smvumbaco/Tubender-FA24/production/ecad/components/footprints/README.md

This is where all component footprints should go
