smvumbaco/Tubender-FA24/production/ecad/components/cad/BX56.IGS

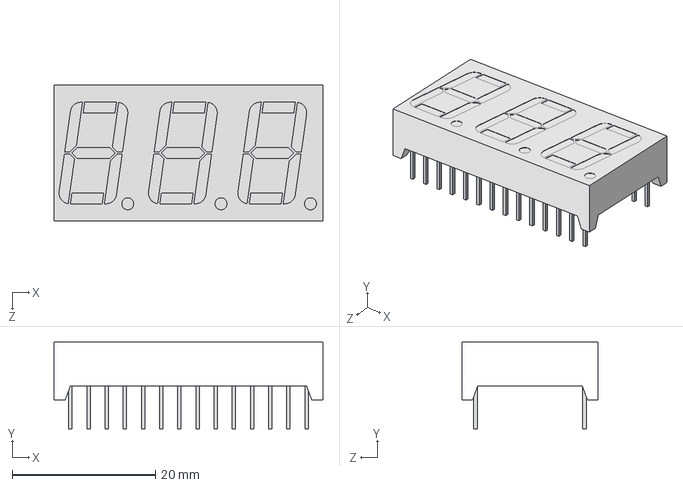
[picture p1: CAD file, 2024-11-20]
production/ecad/components/cad/BX56.IGS
37.6 x 12.1 x 19.0 mm
