smvumbaco/Tubender-FA24/production/ecad/components/cad/PEC11R-4215K-S0024.stp

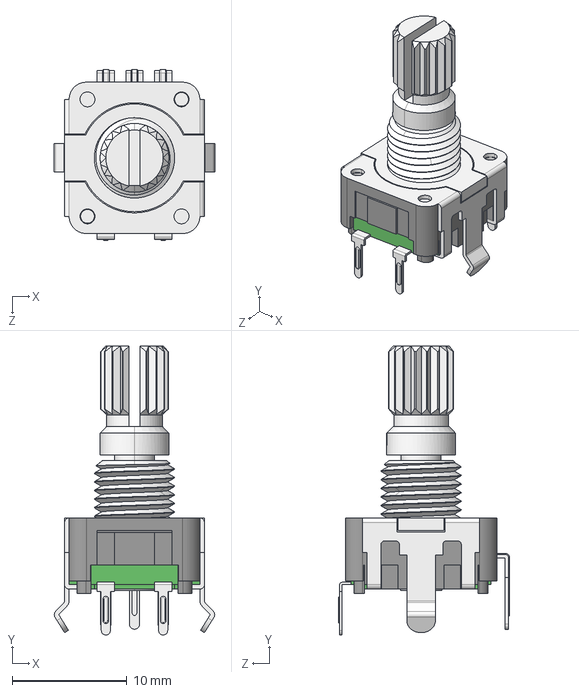
[picture p2: CAD file, 2024-11-20]
production/ecad/components/cad/PEC11R-4215K-S0024.stp
14.0 x 25.2 x 14.9 mm
