smvumbaco/Tubender-FA24/production/ecad/components/cad/D0016A.stp

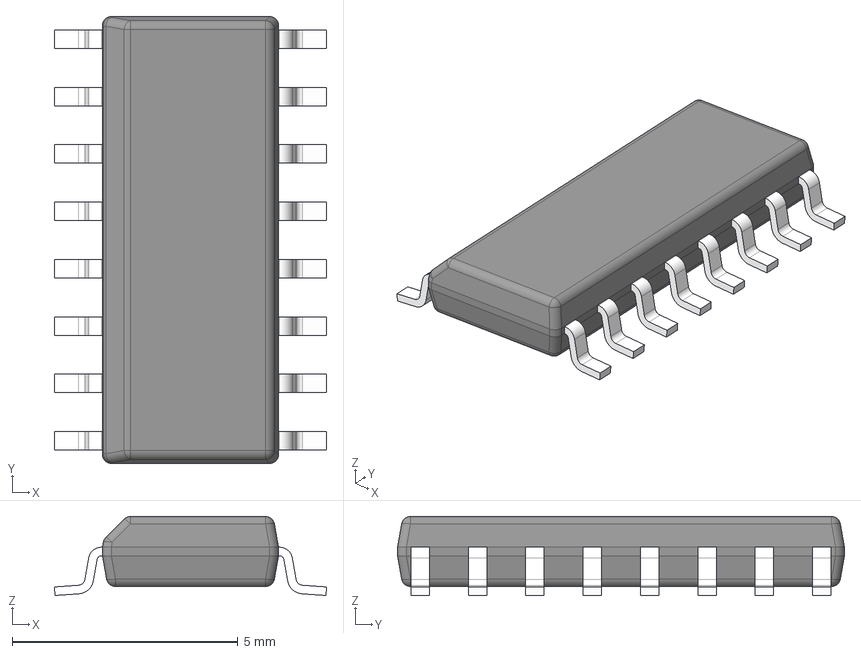
[picture p3: CAD file, 2024-11-20]
production/ecad/components/cad/D0016A.stp
6.03 x 9.90 x 1.75 mm
BODY-SO
LEAD-SO x 16
PIN1-ID
