smvumbaco/Tubender-FA24/production/ecad/components/cad/SN74LVC1G29DCTR.stp

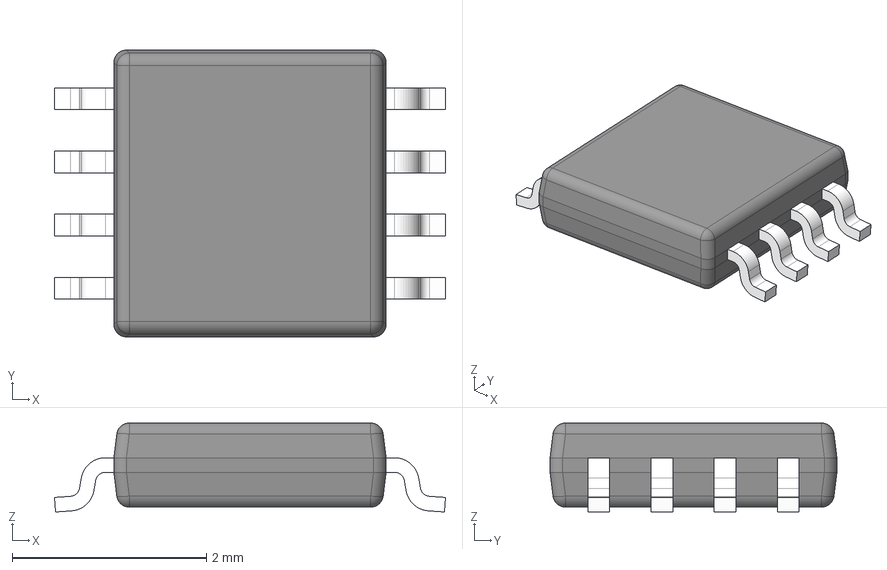
[picture p4: CAD file, 2024-11-20]
production/ecad/components/cad/SN74LVC1G29DCTR.stp
4.02 x 2.95 x 0.915 mm
BODY-SO
LEAD-SO x 8
PIN1-ID
