smvumbaco/Tubender-FA24/production/ecad/components/cad/CP2102N-A02-GQFN28.step

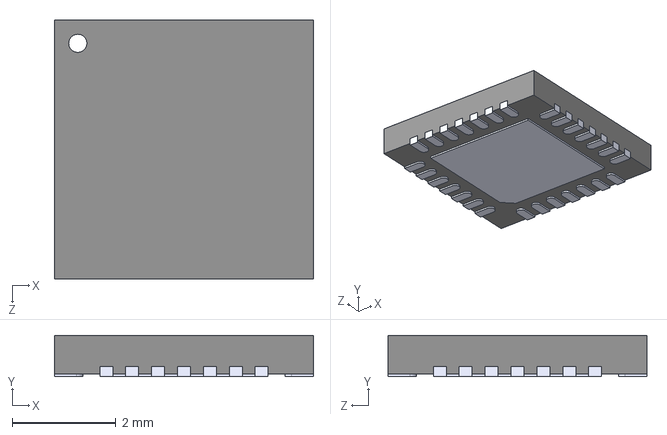
[picture p5: CAD file, 2024-10-16]
production/ecad/components/cad/CP2102N-A02-GQFN28.step
5.00 x 0.8 x 5.00 mm
