smvumbaco/Tubender-FA24/production/ecad/components/cad/1-640387-0.step

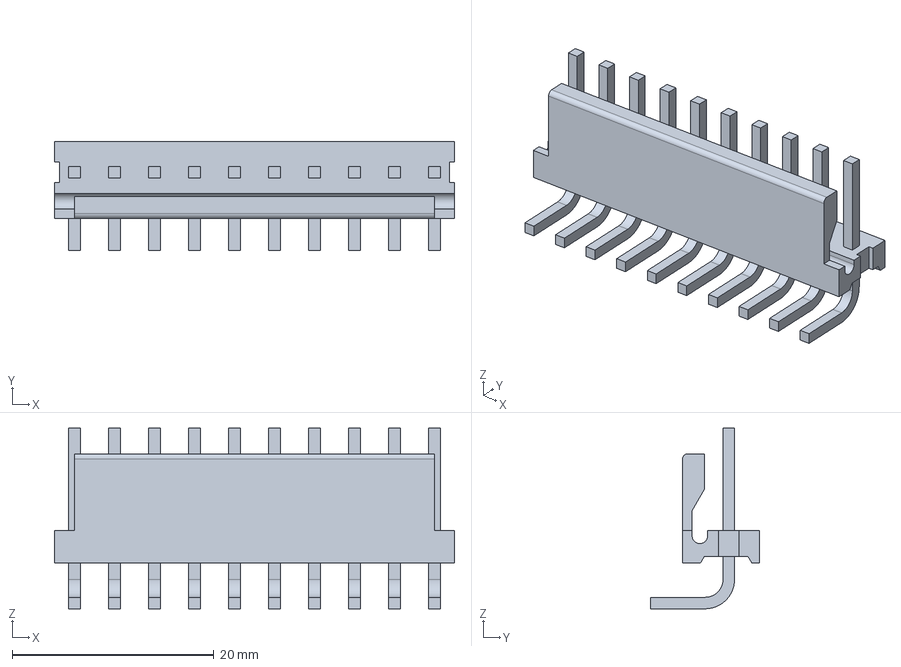
[picture p6: CAD file, 2024-10-16]
production/ecad/components/cad/1-640387-0.step
39.6 x 10.8 x 17.9 mm
