smvumbaco/Tubender-FA24/production/ecad/components/cad/5006.step

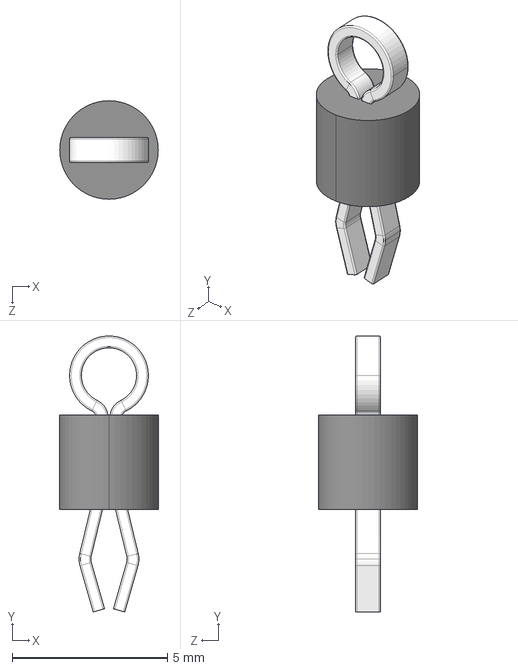
[picture p7: CAD file, 2024-10-16]
production/ecad/components/cad/5006.step
3.17 x 8.89 x 3.17 mm
