smvumbaco/Tubender-FA24/production/ecad/components/cad/ABM8-20.000MHz-10-B1U-T.step

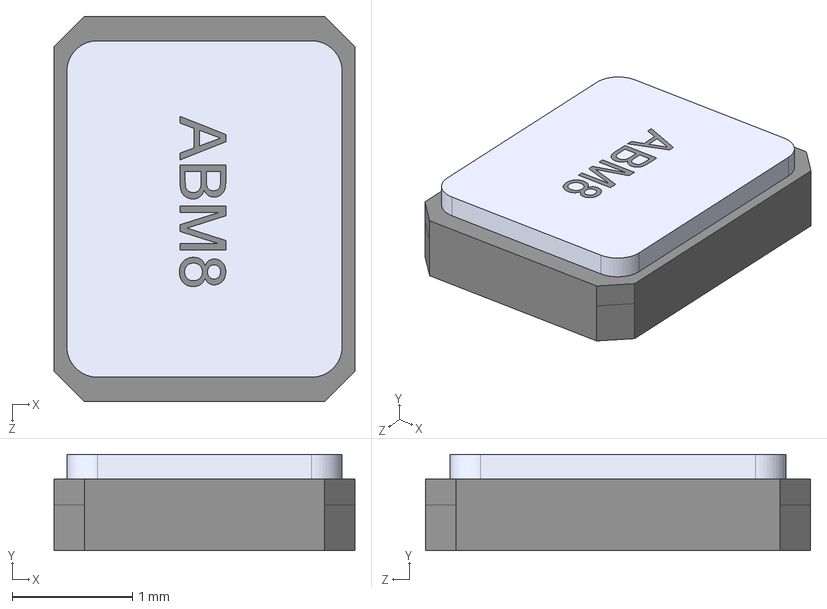
[picture p8: CAD file, 2024-10-11]
production/ecad/components/cad/ABM8-20.000MHz-10-B1U-T.step
2.50 x 0.8 x 3.20 mm
