smvumbaco/Tubender-FA24/production/ecad/components/cad/SN74AHC1G125DBVR.step

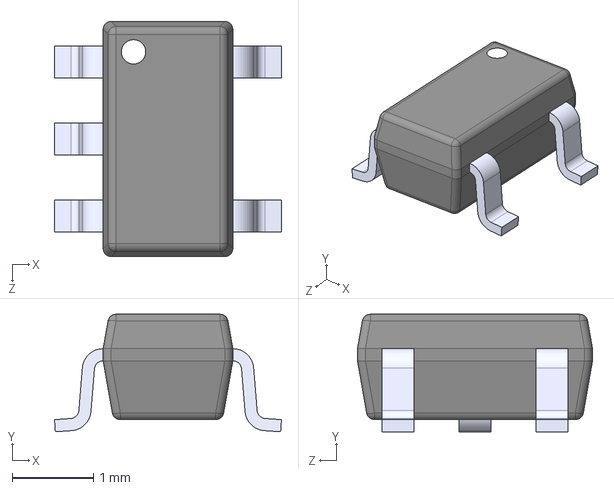
[picture p9: CAD file, 2024-10-11]
production/ecad/components/cad/SN74AHC1G125DBVR.step
2.80 x 1.45 x 2.90 mm
