smvumbaco/Tubender-FA24/production/ecad/components/cad/CD4051BE.step

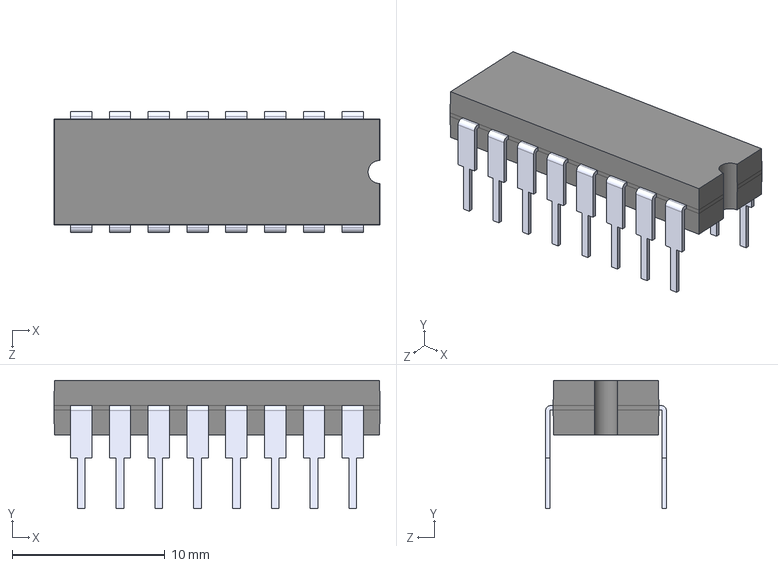
[picture p10: CAD file, 2024-10-11]
production/ecad/components/cad/CD4051BE.step
21.3 x 8.38 x 7.90 mm
