smvumbaco/Tubender-FA24/production/ecad/components/cad/TPSM265R1V5SILR.step

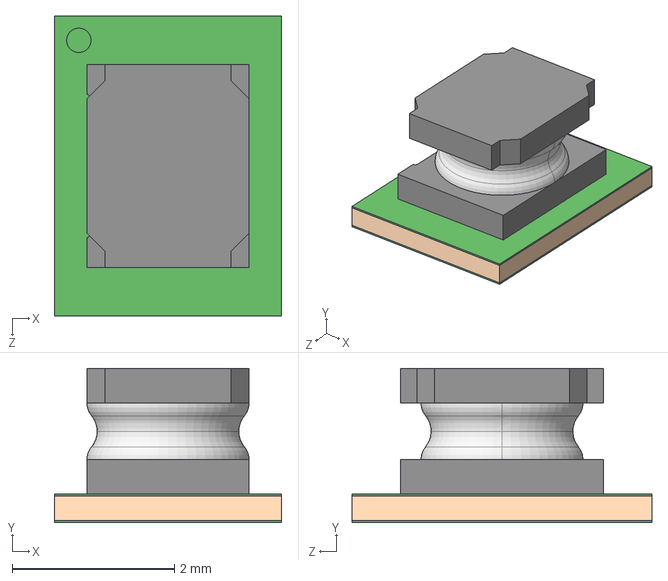
[picture p11: CAD file, 2024-10-10]
production/ecad/components/cad/TPSM265R1V5SILR.step
2.80 x 1.90 x 3.70 mm
