smvumbaco/Tubender-FA24/production/ecad/components/cad/AO3400A.step

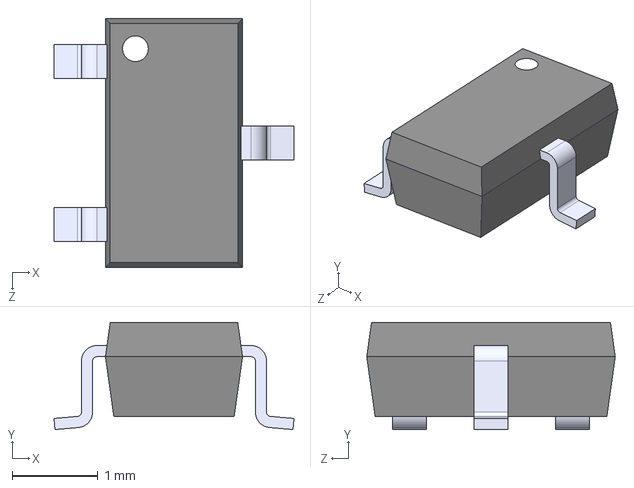
[picture p12: CAD file, 2024-10-03]
production/ecad/components/cad/AO3400A.step
2.80 x 1.25 x 2.90 mm
