smvumbaco/Tubender-FA24/production/ecad/components/cad/TS02-66-70-BK-260-LCR-D.step

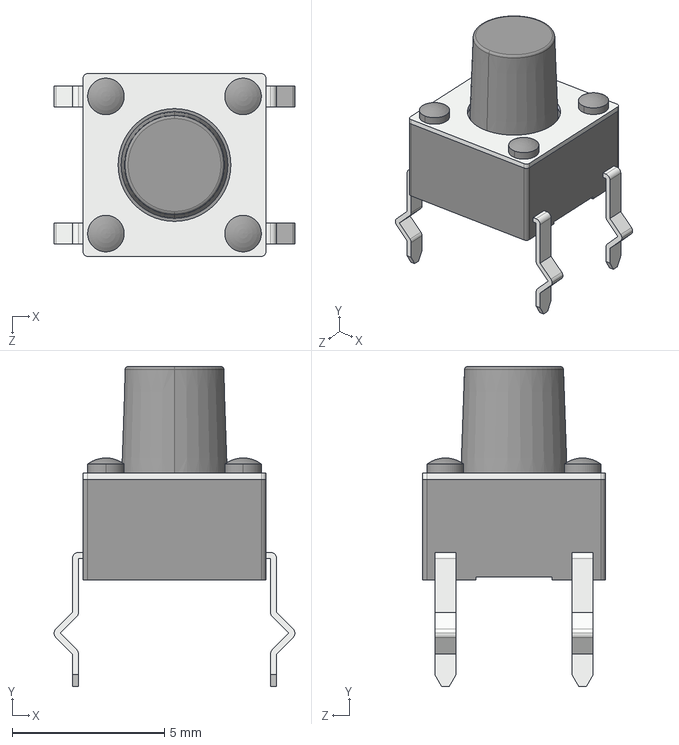
[picture p13: CAD file, 2024-10-03]
production/ecad/components/cad/TS02-66-70-BK-260-LCR-D.step
7.90 x 10.5 x 6.00 mm
