smvumbaco/Tubender-FA24/production/ecad/components/cad/1N5819HW-7-F.step

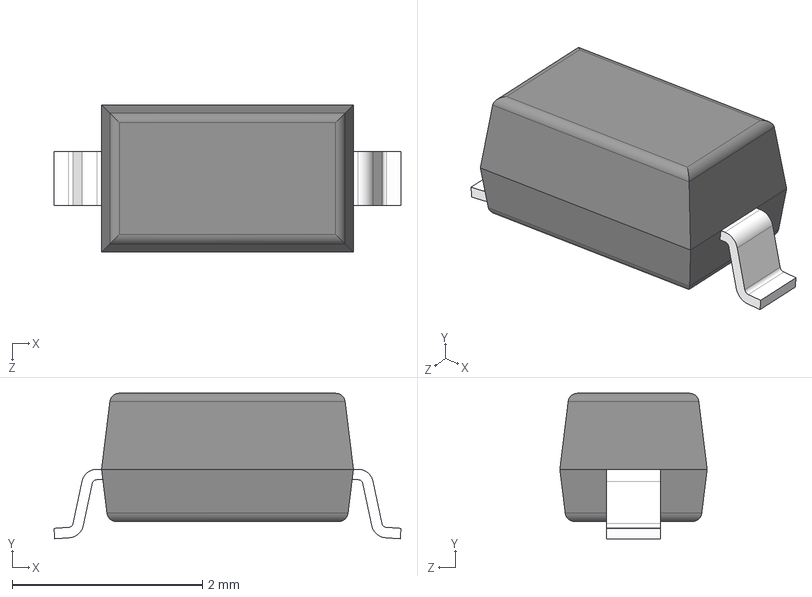
[picture p14: CAD file, 2024-10-03]
production/ecad/components/cad/1N5819HW-7-F.step
3.65 x 1.53 x 1.55 mm
