smvumbaco/Tubender-FA24/production/ecad/components/cad/WL-SMCW_0603.step

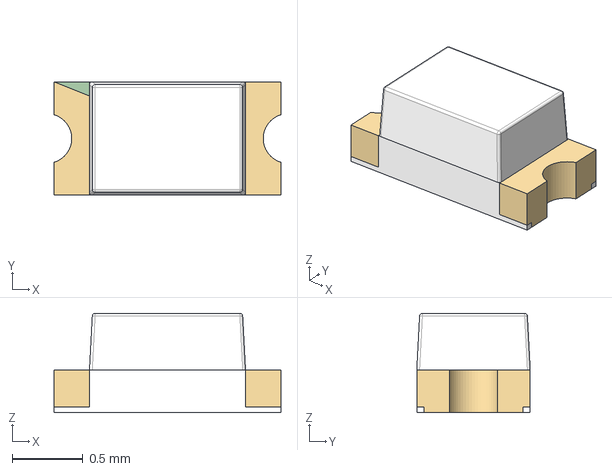
[picture p15: CAD file, 2024-10-03]
production/ecad/components/cad/WL-SMCW_0603.step
1.60 x 0.8 x 0.7 mm
