smvumbaco/Tubender-FA24/production/ecad/components/cad/FT232RL-REEL.step

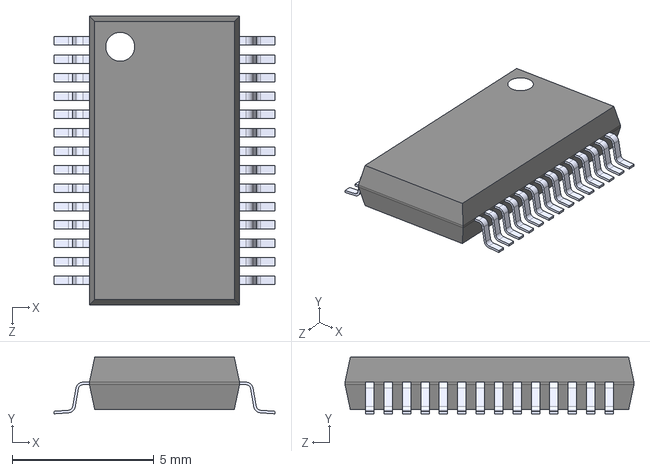
[picture p16: CAD file, 2024-10-03]
production/ecad/components/cad/FT232RL-REEL.step
7.80 x 2.00 x 10.2 mm
