smvumbaco/Tubender-FA24/production/ecad/components/cad/USB4110GFA.step

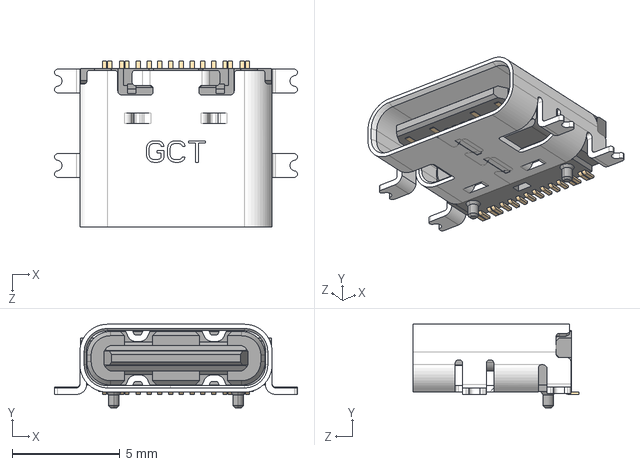
[picture p17: CAD file, 2024-10-03]
production/ecad/components/cad/USB4110GFA.step
11.3 x 3.89 x 7.70 mm
