smvumbaco/Tubender-FA24/production/ecad/components/cad/ESP32-WROOM-32UE_M113EH6400UH3Q0_.step

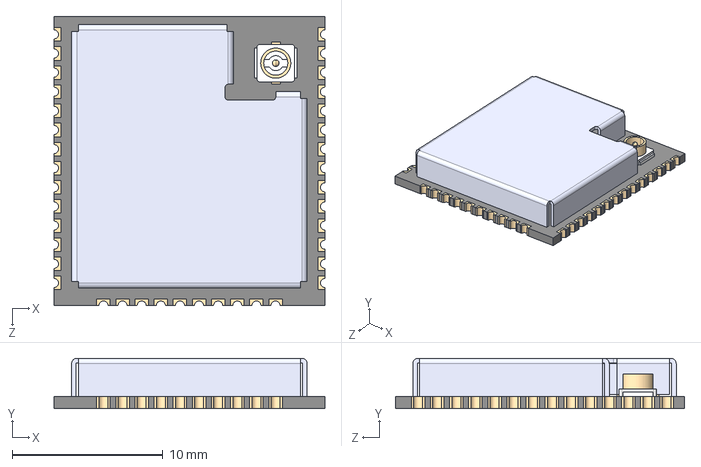
[picture p18: CAD file, 2024-10-03]
production/ecad/components/cad/ESP32-WROOM-32UE_M113EH6400UH3Q0_.step
18.0 x 3.35 x 19.2 mm
