smvumbaco/Tubender-FA24/(list of files, cad)

Other CAD files:
production/ecad/components/cad/104031-0811.stp
production/ecad/components/cad/1729157.step
production/ecad/components/cad/640387-3.step
production/ecad/components/cad/640387-5.stp
production/ecad/components/cad/640387-6.step
production/ecad/components/cad/640387-8.step
production/ecad/components/cad/JS202011JCQN.step
production/ecad/components/cad/LMR36520FADDAR.step
production/ecad/components/cad/MCP23017-E_SO.step
