smvumbaco/Tubender-FA24/production/ecad/Tubender UI_PCB/Tubender UI_PCB.kicad_pcb

## KiCad design production/ecad/Tubender UI_PCB/Tubender UI_PCB.kicad_pcb (2024-11-20)

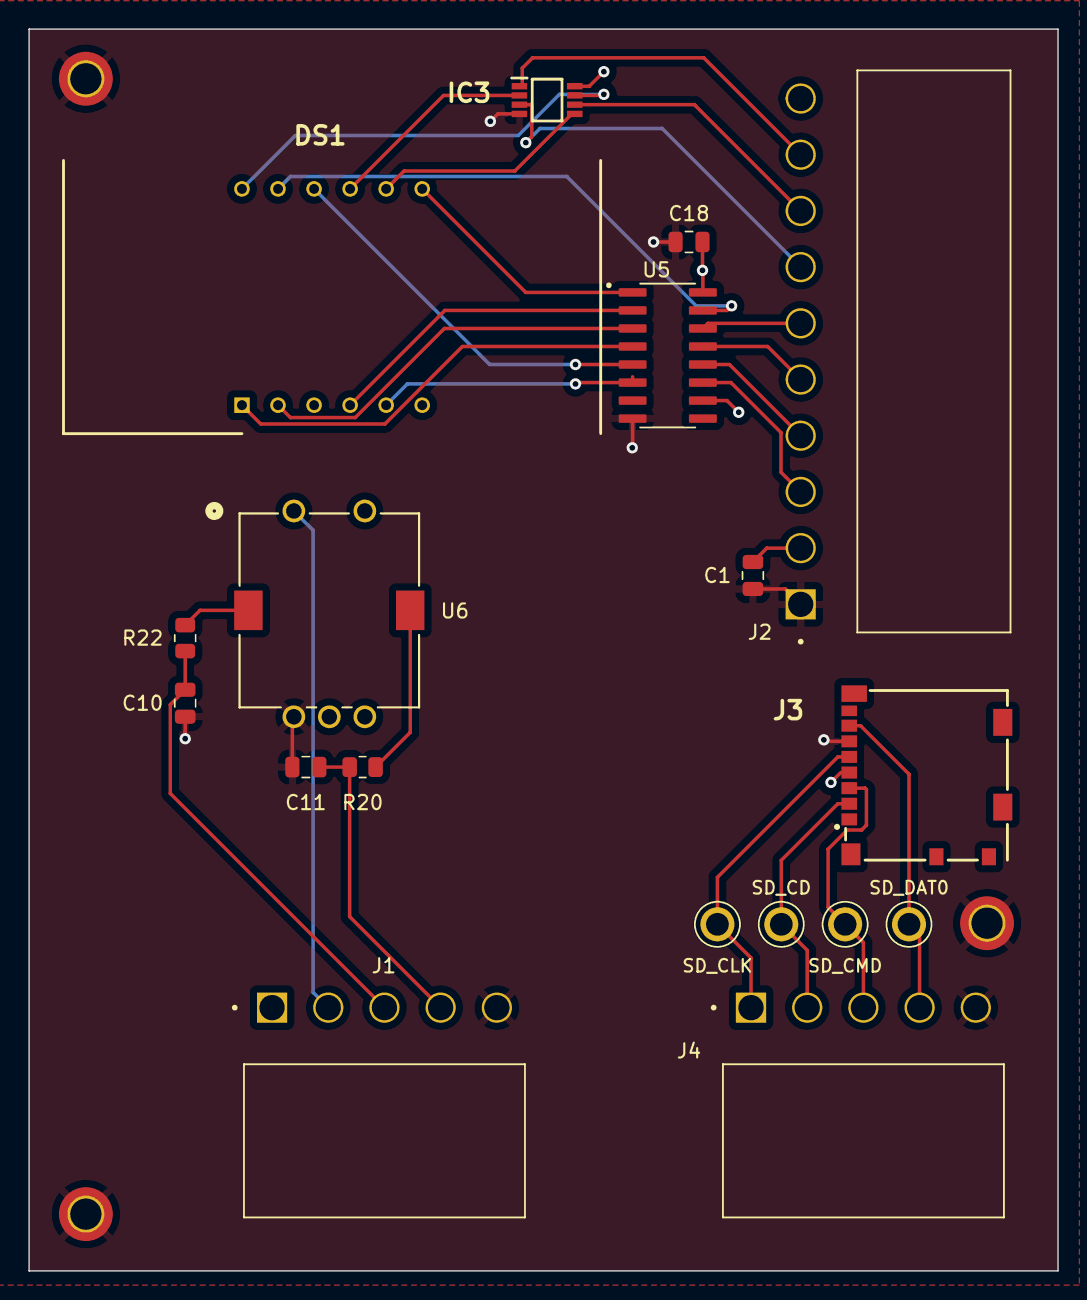
[picture p19: board Tubender UI_PCB.kicad_pcb from above]

Board: 4 copper layers, 72.5 x 87.5 mm, 18 parts (0 on the bottom side), 29 nets.

Parts:
C1: 0.1u; C_0805_2012Metric
C10, C11: 0.01u; C_0805_2012Metric
C18: 0.1uF; C_0805_2012Metric
DS1: BC56-12EWA; DIPS1524W50P254L3760H835Q12N
IC3: SN74LVC1G29DCTR; SOP65P400X130-8N
J1, J4: 640387-5; TE_640387-5
J2: 1-640387-0; TE_1-640387-0
J3: 104031-0811; 1040310811
R20, R22: 10k; R_0805_2012Metric
SD_CD: 5006; KEYSTONE_5006
SD_CLK: 5006; KEYSTONE_5006
SD_CMD: 5006; KEYSTONE_5006
SD_DAT0: 5006; KEYSTONE_5006
U5: 74HC595; SOIC127P600X175-16N
U6: PEC11R-4215K-S0024; SW_PEC11R-4XXXK-SXXXX_BRN

Connections:
7-SEG_A0: IC3.3 (A0), J2.7
7-SEG_A1: IC3.6 (A1), J2.8
7-SEG_Gb: IC3.1 (~G), J2.9
7-SEG_OEb: J2.5, U5.13 (~OE)
7-SEG_RCLK: J2.4, U5.12 (RCLK)
7-SEG_SER: J2.6, U5.14 (SER)
7-SEG_SRCLK: J2.3, U5.11 (SRCLK)
+3V3: C1.1, J2.2, J3.4 (VDD), U5.10 (~SRCLR)
+5V: C18.1, IC3.8 (VCC), J1.1, J2.10, U5.16 (VCC), U6.2
DIAL_BUTTON: J1.2, U6.1
DIAL_CHANNEL_A: C10.1, J1.3, R22.2
DIAL_CHANNEL_B: C11.1, J1.4, R20.2
GND: C1.2, C10.2, C11.2, C18.2, IC3.4 (GND), J1.5, J2.1, J3.6 (VSS), J4.5, U5.8 (GND), U6.5 (C)
unnamed: DS1.11 (ANODE_A), U5.15 (QA)
unnamed: DS1.7 (ANODE_B), U5.1 (QB)
unnamed: DS1.4 (ANODE_C), U5.2 (QC)
unnamed: DS1.2 (ANODE_D), U5.3 (QD)
unnamed: DS1.1 (ANODE_E), U5.4 (QE)
unnamed: DS1.10 (ANODE_F), U5.5 (QF)
unnamed: DS1.5 (ANODE_G), U5.6 (QG)
unnamed: DS1.12 (COMMON_CATHODE_DIG1), IC3.7 (Y0)
unnamed: DS1.9 (COMMON_CATHODE_DIG2), IC3.2 (Y1)
unnamed: DS1.8 (COMMON_CATHODE_DIG_3), IC3.5 (Y2)
unnamed: R22.1, U6.3 (A)
unnamed: R20.1, U6.4 (B)
SD_CD: J3.2 (CD/DAT3), J4.2, SD_CD.TP
SD_CLK: J3.5 (CLK), J4.1, SD_CLK.TP
SD_CMD: J3.3 (CMD), J4.3, SD_CMD.TP
SD_DAT0: J3.7 (DAT0), J4.4, SD_DAT0.TP
