smvumbaco/Tubender-FA24/production/ecad/Tubender PCB/Tubender PCB.kicad_pcb

## KiCad design production/ecad/Tubender PCB/Tubender PCB.kicad_pcb (2024-11-03)

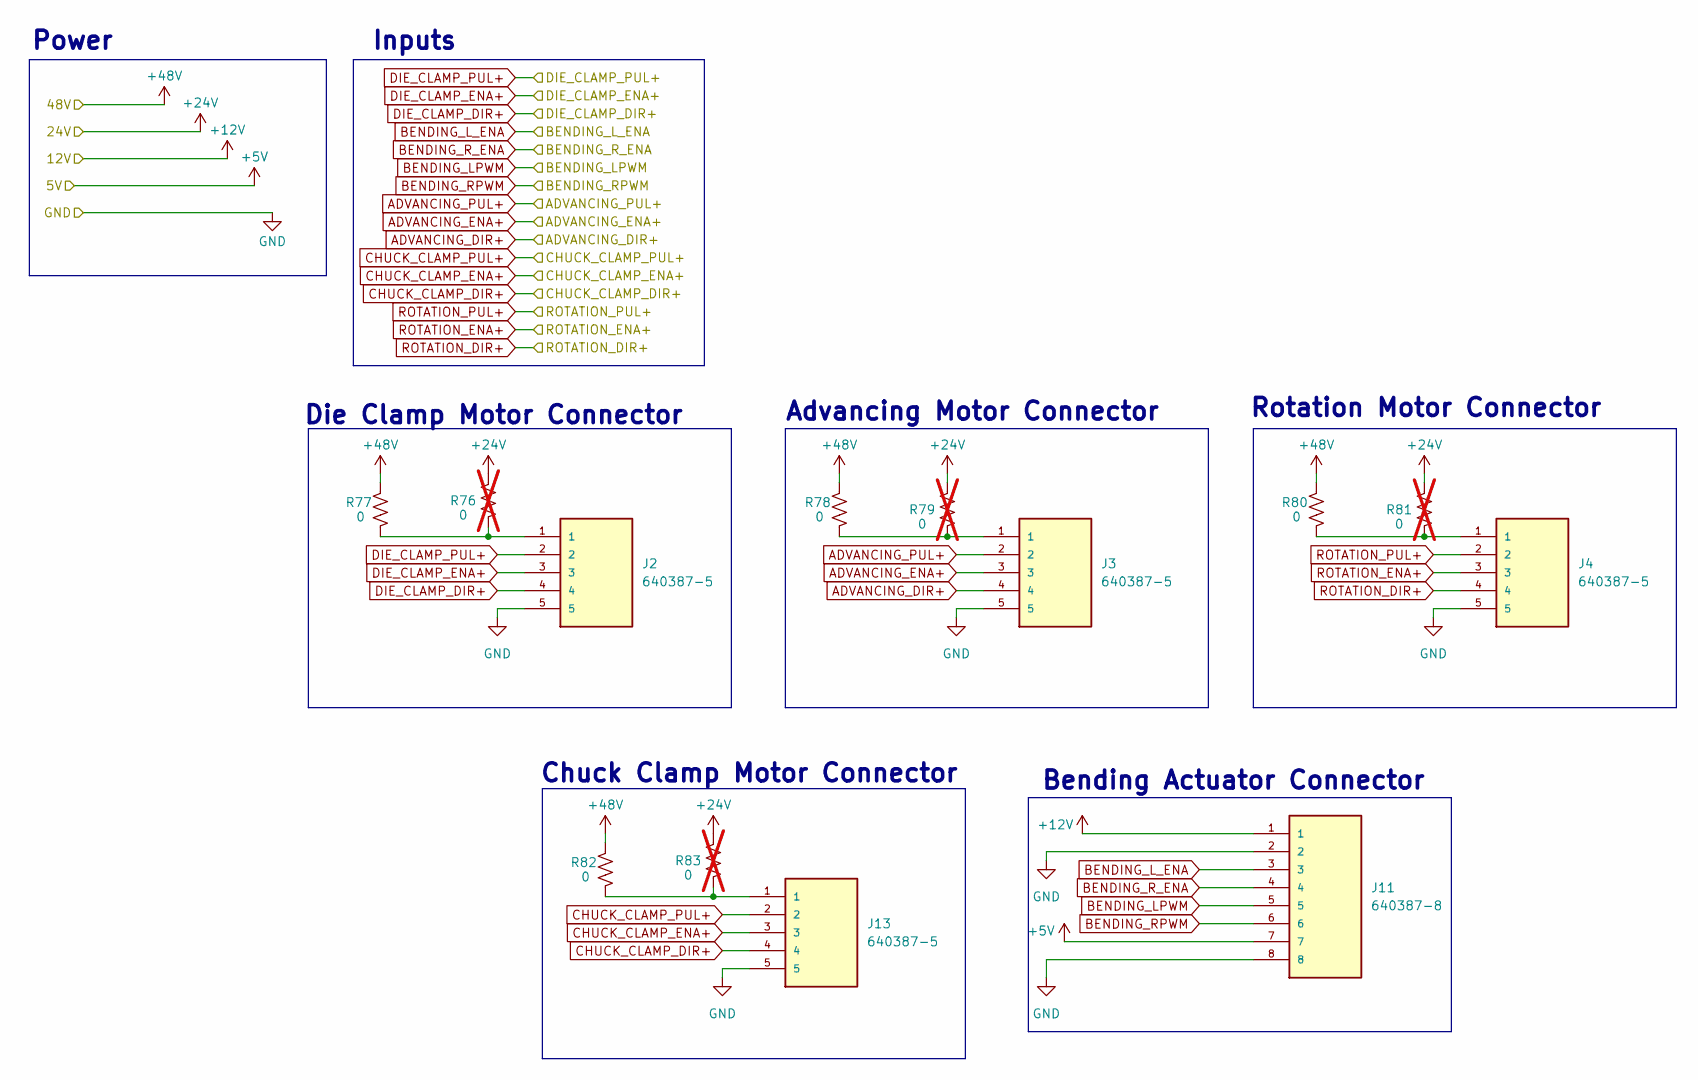
[picture p20: schematic motors_actuators.kicad_sch]

Parts:
J2, J3, J4, J13: 640387-5; TE_640387-5; PARTREV R
J11: 640387-8; TE_640387-8; PARTREV R
R76, R79, R81, R83: 0; R_0805_2012Metric; not fitted
R77, R78, R80, R82: 0; R_0805_2012Metric

Connections:
24V: R76.2, R79.2, R81.2, R83.2; also elsewhere on the board
48V: R77.2, R78.2, R80.2, R82.2; also elsewhere on the board
ADVANCING_DIR+: J3.4; also elsewhere on the board
ADVANCING_ENA+: J3.3; also elsewhere on the board
ADVANCING_PUL+: J3.2; also elsewhere on the board
BENDING_LPWM: J11.5; also elsewhere on the board
BENDING_L_ENA: J11.3; also elsewhere on the board
BENDING_RPWM: J11.6; also elsewhere on the board
BENDING_R_ENA: J11.4; also elsewhere on the board
CHUCK_CLAMP_DIR+: J13.4; also elsewhere on the board
CHUCK_CLAMP_ENA+: J13.3; also elsewhere on the board
CHUCK_CLAMP_PUL+: J13.2; also elsewhere on the board
DIE_CLAMP_DIR+: J2.4; also elsewhere on the board
DIE_CLAMP_ENA+: J2.3; also elsewhere on the board
DIE_CLAMP_PUL+: J2.2; also elsewhere on the board
unnamed: J2.1, R76.1, R77.1
unnamed: J3.1, R78.1, R79.1
unnamed: J4.1, R80.1, R81.1
unnamed: J13.1, R82.1, R83.1
ROTATION_DIR+: J4.4; also elsewhere on the board
ROTATION_ENA+: J4.3; also elsewhere on the board
ROTATION_PUL+: J4.2; also elsewhere on the board

Notes on the sheet:
Chuck Clamp Motor Connector
Die Clamp Motor Connector
Bending Actuator Connector
Inputs
Advancing Motor Connector
Power
Rotation Motor Connector

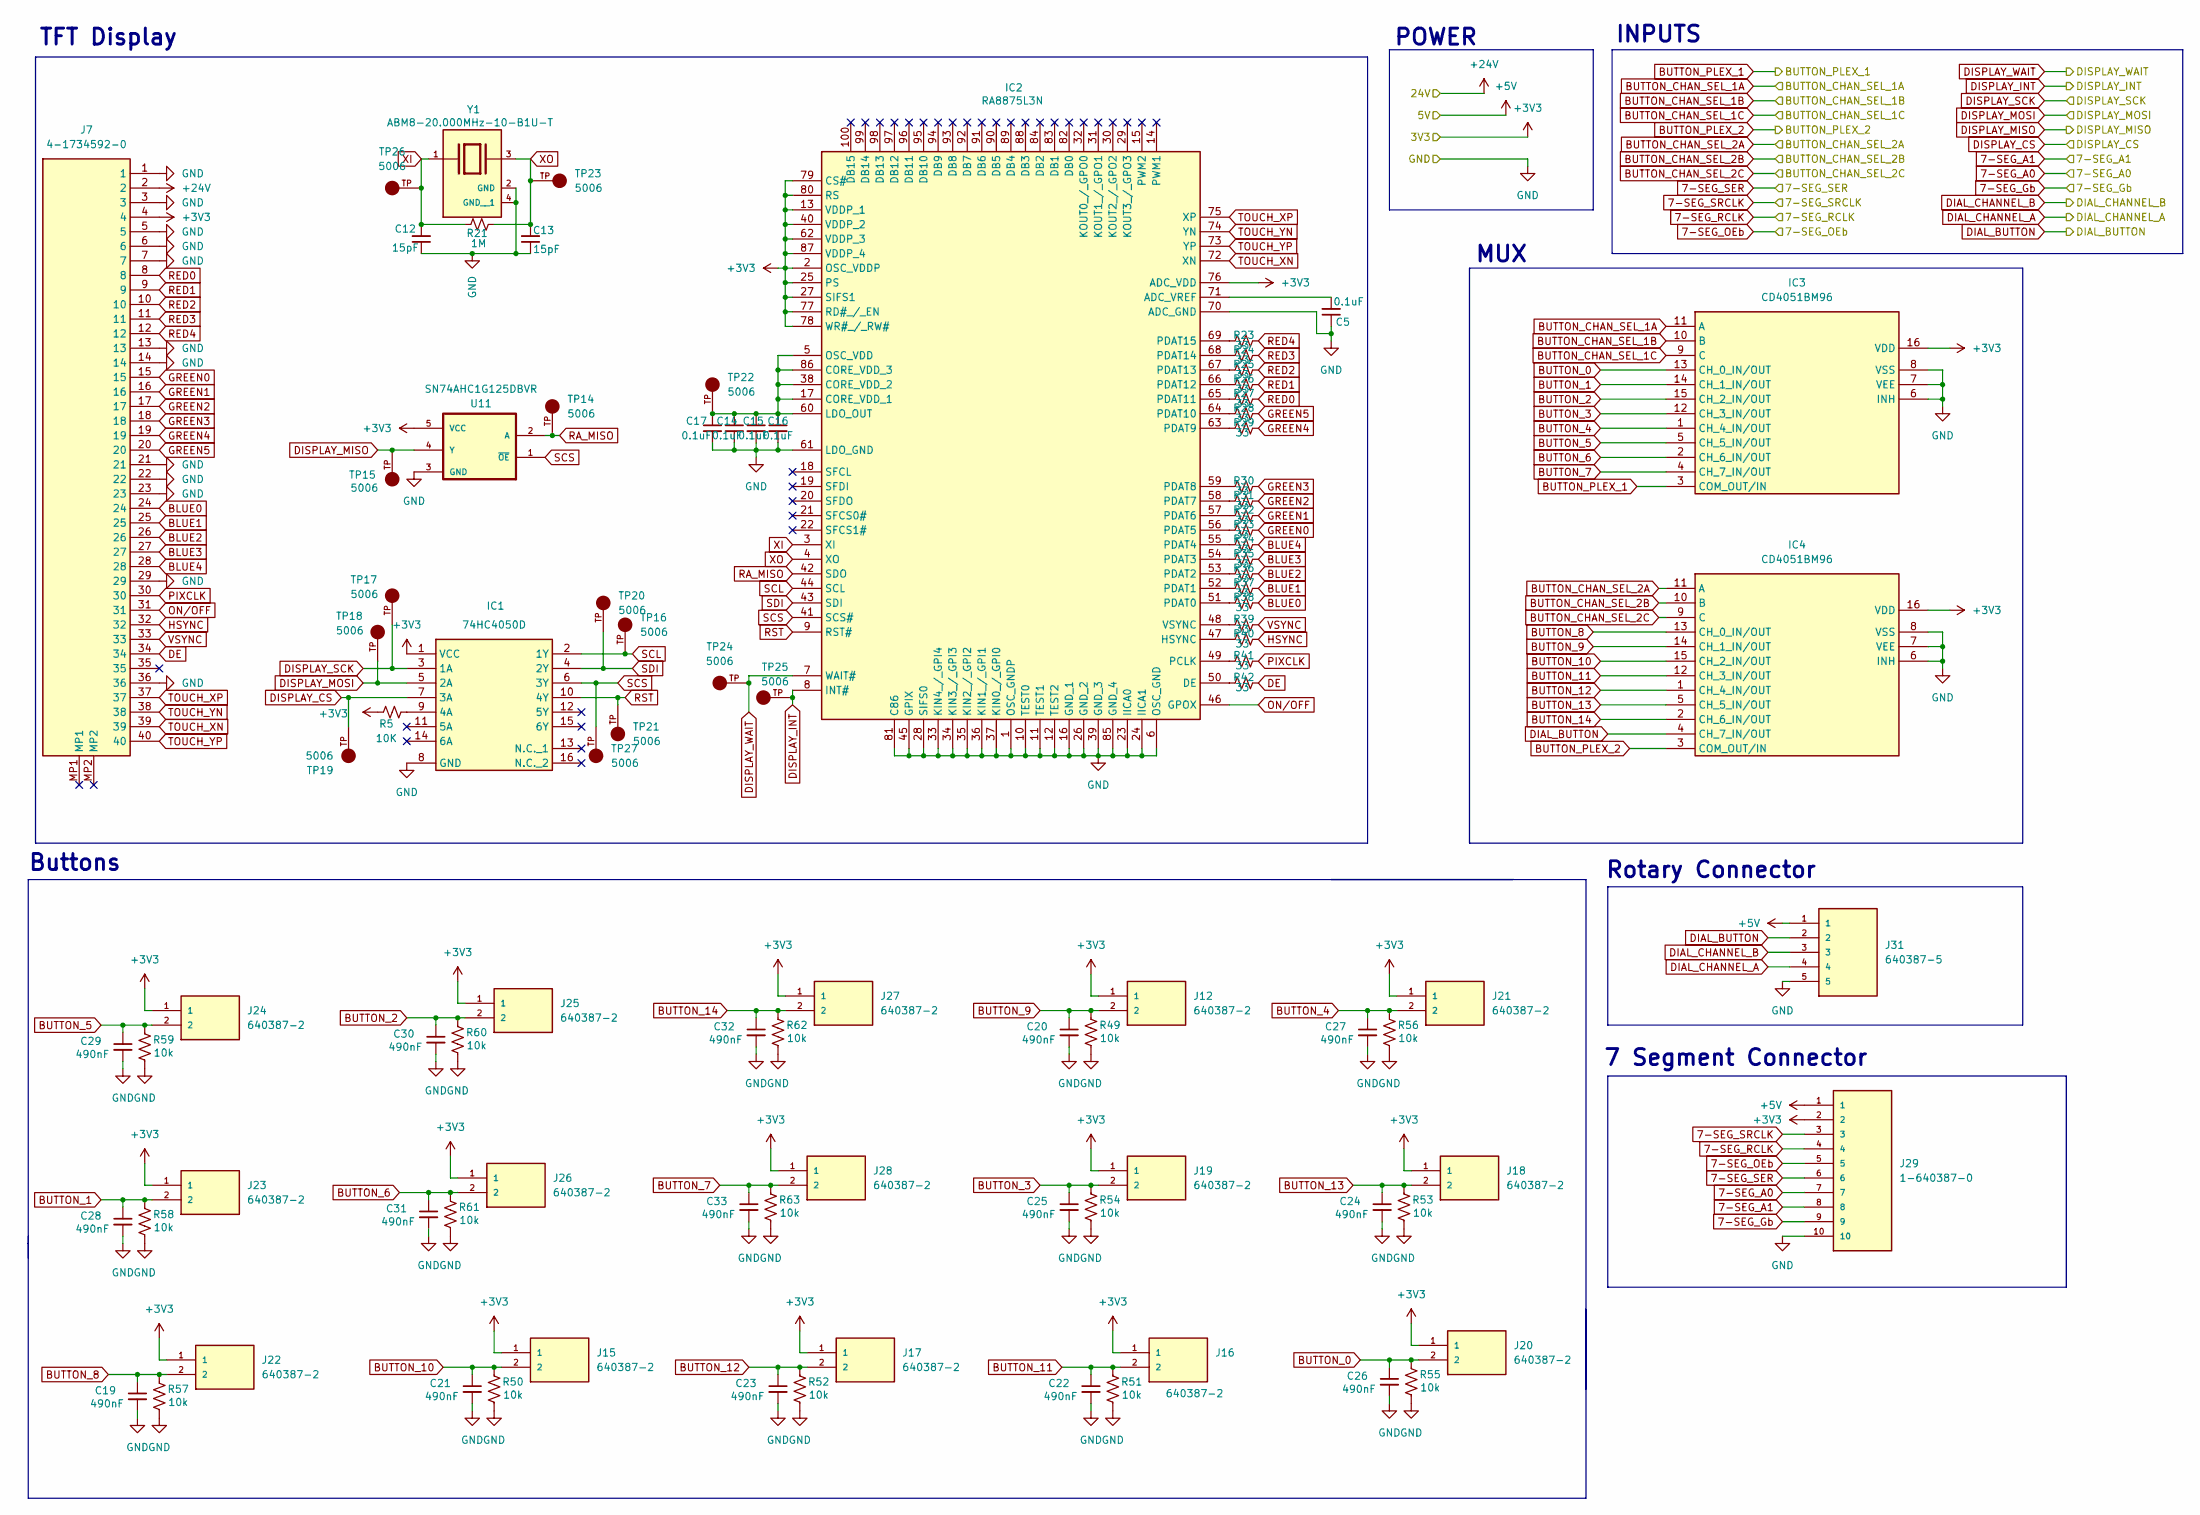
[picture p21: schematic user_interface.kicad_sch]

Parts:
C5, C14, C15, C16, C17: 0.1uF; C_0805_2012Metric
C12, C13: 15pF; C_0805_2012Metric
C19, C20, C21, C22, C23, C24, C25, C26, C27, C28, C29, C30, C31, C32, C33: 490nF; C_0805_2012Metric
IC1: 74HC4050D; SOT109-1_NXP; Manufacturer_Part_Number 74HC4050D; Mouser Part Number 771-74HC4050D
IC2: RA8875L3N; QFP40P1600X1600X160-128N; Manufacturer_Part_Number RA8875L3N
IC3, IC4: CD4051BM96; SOIC127P600X175-16N; Manufacturer_Part_Number CD4051BM96; Mouser Part Number 595-CD4051BM96
J7: 4-1734592-0; TE_4-1734592-0; Manufacturer_Part_Number 4-1734592-0; Mouser Part Number 571-4-1734592-0
J12, J15, J16, J17, J18, J19, J20, J21, J22, J23, J24, J25, J26, J27, J28: 640387-2; TE_640387-2; PARTREV R
J29: 1-640387-0; TE_1-640387-0; PARTREV R
J31: 640387-5; TE_640387-5; PARTREV R
R5: 10K; R_0805_2012Metric
R21: 1M; R_0805_2012Metric
R23, R24, R25, R26, R27, R28, R29, R30, R31, R32, R33, R34, R35, R36, R37, R38, R39, R40, R41, R42: 33; R_0805_2012Metric
R49, R50, R51, R52, R53, R54, R55, R56, R57, R58, R59, R60, R61, R62, R63: 10k; R_0805_2012Metric
TP14, TP15, TP16, TP17, TP18, TP19, TP20, TP21, TP22, TP23, TP24, TP25, TP26, TP27: 5006; KEYSTONE_5006; PARTREV F
U11: SN74AHC1G125DBVR; SOT95P280X145-5N
Y1: ABM8-20.000MHz-10-B1U-T; XTAL_ABM8-20.000MHz-10-B1U-T; PARTREV 44041

Connections:
3.3V: IC1.1 (VCC), IC2.2 (OSC_VDDP), IC2.13 (VDDP_1), IC2.25 (PS), IC2.27 (SIFS1), IC2.40 (VDDP_2), IC2.62 (VDDP_3), IC2.76 (ADC_VDD), IC2.77 (RD#_/_EN), IC2.78 (WR#_/_RW#), IC2.79 (CS#), IC2.80 (RS), IC2.87 (VDDP_4), IC3.16 (VDD), IC4.16 (VDD), J7.4, J12.1, J15.1, J16.1, J17.1, J18.1, J19.1, J20.1, J21.1, J22.1, J23.1, J24.1, J25.1, J26.1, J27.1, J28.1, J29.2, R5.2, U11.5 (VCC); also elsewhere on the board
7-SEG_A0: J29.7; also elsewhere on the board
7-SEG_A1: J29.8; also elsewhere on the board
7-SEG_Gb: J29.9; also elsewhere on the board
7-SEG_OEb: J29.5; also elsewhere on the board
7-SEG_RCLK: J29.4; also elsewhere on the board
7-SEG_SER: J29.6; also elsewhere on the board
7-SEG_SRCLK: J29.3; also elsewhere on the board
24V: J7.2; also elsewhere on the board
BLUE0: J7.24, R38.2
BLUE1: J7.25, R37.2
BLUE2: J7.26, R36.2
BLUE3: J7.27, R35.2
BLUE4: J7.28, R34.2
BUTTON_0: C26.1, IC3.13 (CH_0_IN/OUT), J20.2, R55.2
BUTTON_1: C28.1, IC3.14 (CH_1_IN/OUT), J23.2, R58.2
BUTTON_2: C30.1, IC3.15 (CH_2_IN/OUT), J25.2, R60.2
BUTTON_3: C25.1, IC3.12 (CH_3_IN/OUT), J19.2, R54.2
BUTTON_4: C27.1, IC3.1 (CH_4_IN/OUT), J21.2, R56.2
BUTTON_5: C29.1, IC3.5 (CH_5_IN/OUT), J24.2, R59.2
BUTTON_6: C31.1, IC3.2 (CH_6_IN/OUT), J26.2, R61.2
BUTTON_7: C33.1, IC3.4 (CH_7_IN/OUT), J28.2, R63.2
BUTTON_8: C19.1, IC4.13 (CH_0_IN/OUT), J22.2, R57.2
BUTTON_9: C20.1, IC4.14 (CH_1_IN/OUT), J12.2, R49.2
BUTTON_10: C21.1, IC4.15 (CH_2_IN/OUT), J15.2, R50.2
BUTTON_11: C22.1, IC4.12 (CH_3_IN/OUT), J16.2, R51.2
BUTTON_12: C23.1, IC4.1 (CH_4_IN/OUT), J17.2, R52.2
BUTTON_13: C24.1, IC4.5 (CH_5_IN/OUT), J18.2, R53.2
BUTTON_14: C32.1, IC4.2 (CH_6_IN/OUT), J27.2, R62.2
BUTTON_CHAN_SEL_1A: IC3.11 (A); also elsewhere on the board
BUTTON_CHAN_SEL_1B: IC3.10 (B); also elsewhere on the board
BUTTON_CHAN_SEL_1C: IC3.9 (C); also elsewhere on the board
BUTTON_CHAN_SEL_2A: IC4.11 (A); also elsewhere on the board
BUTTON_CHAN_SEL_2B: IC4.10 (B); also elsewhere on the board
BUTTON_CHAN_SEL_2C: IC4.9 (C); also elsewhere on the board
BUTTON_PLEX_1: IC3.3 (COM_OUT/IN); also elsewhere on the board
BUTTON_PLEX_2: IC4.3 (COM_OUT/IN); also elsewhere on the board
DE: J7.34, R42.2
DIAL_BUTTON: IC4.4 (CH_7_IN/OUT), J31.2
DIAL_CHANNEL_A: J31.4; also elsewhere on the board
DIAL_CHANNEL_B: J31.3; also elsewhere on the board
DISPLAY_CS: IC1.7 (3A), TP19.TP; also elsewhere on the board
DISPLAY_INT: IC2.8 (INT#), TP25.TP; also elsewhere on the board
DISPLAY_MISO: TP15.TP, U11.4 (Y); also elsewhere on the board
DISPLAY_MOSI: IC1.5 (2A), TP18.TP; also elsewhere on the board
DISPLAY_SCK: IC1.3 (1A), TP17.TP; also elsewhere on the board
DISPLAY_WAIT: IC2.7 (WAIT#), TP24.TP; also elsewhere on the board
GREEN0: J7.15, R33.2
GREEN1: J7.16, R32.2
GREEN2: J7.17, R31.2
GREEN3: J7.18, R30.2
GREEN4: J7.19, R29.2
GREEN5: J7.20, R28.2
HSYNC: J7.32, R40.2
unnamed: IC1.9 (4A), R5.1
unnamed: C5.2, IC2.71 (ADC_VREF)
unnamed: C14.1, C15.1, C16.1, C17.1, IC2.5 (OSC_VDD), IC2.17 (CORE_VDD_1), IC2.38 (CORE_VDD_2), IC2.60 (LDO_OUT), IC2.86 (CORE_VDD_3), TP22.TP
unnamed: IC2.50 (DE), R42.1
unnamed: IC2.47 (HSYNC), R40.1
unnamed: IC2.49 (PCLK), R41.1
unnamed: IC2.51 (PDAT0), R38.1
unnamed: IC2.52 (PDAT1), R37.1
unnamed: IC2.53 (PDAT2), R36.1
unnamed: IC2.54 (PDAT3), R35.1
unnamed: IC2.55 (PDAT4), R34.1
unnamed: IC2.56 (PDAT5), R33.1
unnamed: IC2.57 (PDAT6), R32.1
unnamed: IC2.58 (PDAT7), R31.1
unnamed: IC2.59 (PDAT8), R30.1
unnamed: IC2.63 (PDAT9), R29.1
unnamed: IC2.64 (PDAT10), R28.1
unnamed: IC2.65 (PDAT11), R27.1
unnamed: IC2.66 (PDAT12), R26.1
unnamed: IC2.67 (PDAT13), R25.1
unnamed: IC2.68 (PDAT14), R24.1
unnamed: IC2.69 (PDAT15), R23.1
unnamed: IC2.48 (VSYNC), R39.1
ON/OFF: IC2.46 (GPOX), J7.31
PIXCLK: J7.30, R41.2
RA_MISO: IC2.42 (SDO), TP14.TP, U11.2 (A)
RED0: J7.8, R27.2
RED1: J7.9, R26.2
RED2: J7.10, R25.2
RED3: J7.11, R24.2
RED4: J7.12, R23.2
RST: IC1.10 (4Y), IC2.9 (RST#), TP21.TP
SCL: IC1.2 (1Y), IC2.44 (SCL), TP16.TP
SCS: IC1.6 (3Y), IC2.41 (SCS#), TP27.TP, U11.1 (~OE)
SDI: IC1.4 (2Y), IC2.43 (SDI), TP20.TP
TOUCH_XN: IC2.72 (XN), J7.39
TOUCH_XP: IC2.75 (XP), J7.37
TOUCH_YN: IC2.74 (YN), J7.38
TOUCH_YP: IC2.73 (YP), J7.40
VSYNC: J7.33, R39.2
XI: C12.2, IC2.3 (XI), R21.1, TP26.TP, Y1.1
XO: C13.2, IC2.4 (XO), R21.2, TP23.TP, Y1.3

Notes on the sheet:
INPUTS
POWER
TFT Display
MUX
7 Segment Connector
Rotary Connector
Buttons

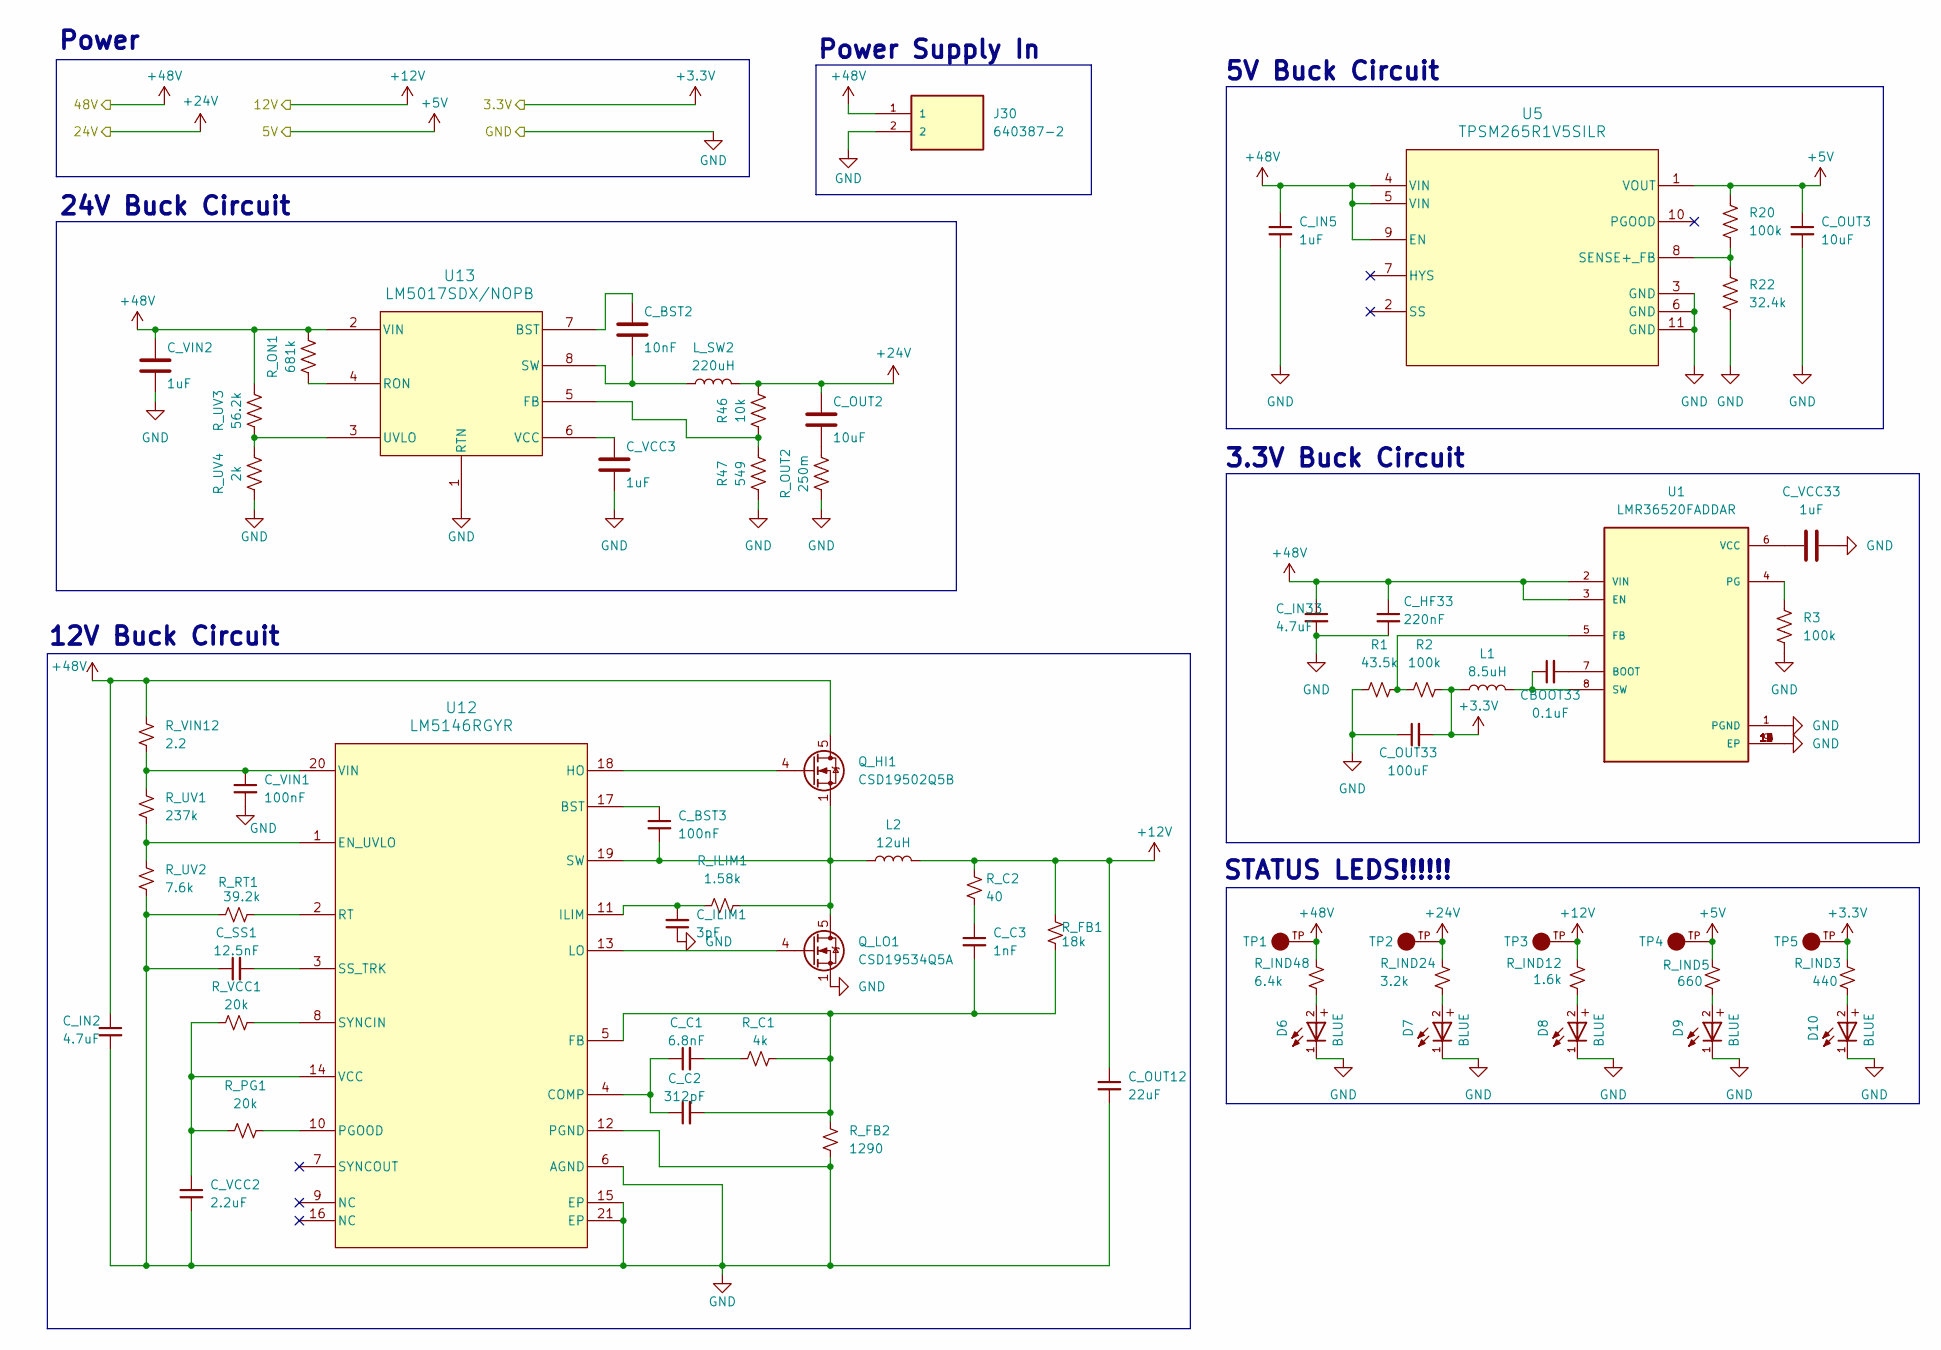
[picture p22: schematic power.kicad_sch]

Parts:
CBOOT33: 0.1uF; C_0805_2012Metric
C_BST2: 10nF; C_0805_2012Metric
C_BST3: 100nF; C_0805_2012Metric
C_C1: 6.8nF; C_0805_2012Metric
C_C2: 312pF; C_0805_2012Metric
C_C3: 1nF; C_0805_2012Metric
C_HF33: 220nF; C_0805_2012Metric
C_ILIM1: 3pF; C_0805_2012Metric
C_IN2, C_IN33: 4.7uF; C_0805_2012Metric
C_IN5: 1uF; C_0805_2012Metric
C_OUT2, C_OUT3: 10uF; C_0805_2012Metric
C_OUT12: 22uF; C_0805_2012Metric
C_OUT33: 100uF; C_0805_2012Metric
C_SS1: 12.5nF; C_0805_2012Metric
C_VCC2: 2.2uF; C_0805_2012Metric
C_VCC3, C_VCC33: 1uF; C_0805_2012Metric
C_VIN1: 100nF; C_0805_2012Metric
C_VIN2: 1uF; C_0805_2012Metric
D6, D7, D8, D9, D10: BLUE; WL-SMCW_0603
J30: 640387-2; TE_640387-2; PARTREV R
L1: 8.5uH; L_0805_2012Metric
L2: 12uH; L_0805_2012Metric
L_SW2: 220uH; L_0805_2012Metric
Q_HI1: CSD19502Q5B; TDSON-8-1
Q_LO1: CSD19534Q5A; TDSON-8-1
R1: 43.5k; R_0805_2012Metric
R2, R3, R20: 100k; R_0805_2012Metric
R22: 32.4k; R_0805_2012Metric
R46: 10k; R_0805_2012Metric
R47: 549; R_0805_2012Metric
R_C1: 4k; R_0805_2012Metric
R_C2: 40; R_0805_2012Metric
R_FB1: 18k; R_0805_2012Metric
R_FB2: 1290; R_0805_2012Metric
R_ILIM1: 1.58k; R_0805_2012Metric
R_IND3: 440; R_0805_2012Metric
R_IND5: 660; R_0805_2012Metric
R_IND12: 1.6k; R_0805_2012Metric
R_IND24: 3.2k; R_0805_2012Metric
R_IND48: 6.4k; R_0805_2012Metric
R_ON1: 681k; R_0805_2012Metric
R_OUT2: 250m; R_0805_2012Metric
R_PG1: 20k; R_0805_2012Metric
R_RT1: 39.2k; R_0805_2012Metric
R_UV1: 237k; R_0805_2012Metric
R_UV2: 7.6k; R_0805_2012Metric
R_UV3: 56.2k; R_0805_2012Metric
R_UV4: 2k; R_0805_2012Metric
R_VCC1: 20k; R_0805_2012Metric
R_VIN12: 2.2; R_0805_2012Metric
TP1, TP2, TP3, TP4, TP5: 5006; KEYSTONE_5006; PARTREV F
U1: LMR36520FADDAR; IC_LMR36520FADDAR; PARTREV B
U5: TPSM265R1V5SILR; SIL0010C
U12: LM5146RGYR; RGY0020B-MFG
U13: LM5017SDX/NOPB; SDC08B

Connections:
3.3V: C_OUT33.2, L1.1, R2.2, R_IND3.1, TP5.TP; also elsewhere on the board
24V: C_OUT2.1, L_SW2.2, R46.2, R_IND24.1, TP2.TP; also elsewhere on the board
48V: C_HF33.1, C_IN2.1, C_IN5.1, C_IN33.1, C_VIN2.1, J30.1, Q_HI1.5 (D), R_IND48.1, R_ON1.2, R_UV3.2, R_VIN12.1, TP1.TP, U1.2 (VIN), U1.3 (EN), U5.4 (VIN), U5.5 (VIN), U5.9 (EN), U13.2 (VIN); also elsewhere on the board
unnamed: C_C1.2, R_C1.1
unnamed: C_C3.1, R_C2.2
unnamed: C_OUT2.2, R_OUT2.2
unnamed: D6.2, R_IND48.2
unnamed: D7.2, R_IND24.2
unnamed: D8.2, R_IND12.2
unnamed: D9.2, R_IND5.2
unnamed: D10.2, R_IND3.2
unnamed: Q_HI1.4 (G), U12.18 (HO)
unnamed: C_BST3.2, L2.1, Q_HI1.1 (S), Q_HI1.2 (S), Q_HI1.3 (S), Q_LO1.5 (D), R_ILIM1.2, U12.19 (SW)
unnamed: Q_LO1.4 (G), U12.13 (LO)
unnamed: CBOOT33.2, U1.7 (BOOT)
unnamed: R1.2, R2.1, U1.5 (FB)
unnamed: R3.2, U1.4 (PG)
unnamed: CBOOT33.1, L1.2, U1.8 (SW)
unnamed: C_VCC33.1, U1.6 (VCC)
unnamed: R20.1, R22.2, U5.8 (SENSE+_FB)
unnamed: C_BST3.1, U12.17 (BST)
unnamed: C_C1.1, C_C2.1, U12.4 (COMP)
unnamed: R_UV1.2, R_UV2.1, U12.1 (EN_UVLO)
unnamed: C_C2.2, C_C3.2, R_C1.2, R_FB1.2, R_FB2.1, U12.5 (FB)
unnamed: C_ILIM1.2, R_ILIM1.1, U12.11 (ILIM)
unnamed: R_PG1.2, U12.10 (PGOOD)
unnamed: R_RT1.2, U12.2 (RT)
unnamed: C_SS1.2, U12.3 (SS_TRK)
unnamed: R_VCC1.1, U12.8 (SYNCIN)
unnamed: C_VCC2.1, R_PG1.1, R_VCC1.2, U12.14 (VCC)
unnamed: C_VIN1.1, R_UV1.1, R_VIN12.2, U12.20 (VIN)
unnamed: C_BST2.1, U13.7 (BST)
unnamed: R46.1, R47.2, U13.5 (FB)
unnamed: R_ON1.1, U13.4 (RON)
unnamed: C_BST2.2, L_SW2.1, U13.8 (SW)
unnamed: R_UV3.1, R_UV4.2, U13.3 (UVLO)
unnamed: C_VCC3.1, U13.6 (VCC)

Notes on the sheet:
12V Buck Circuit
Power
STATUS LEDS!!!!!!
Power Supply In
24V Buck Circuit
3.3V Buck Circuit
5V Buck Circuit

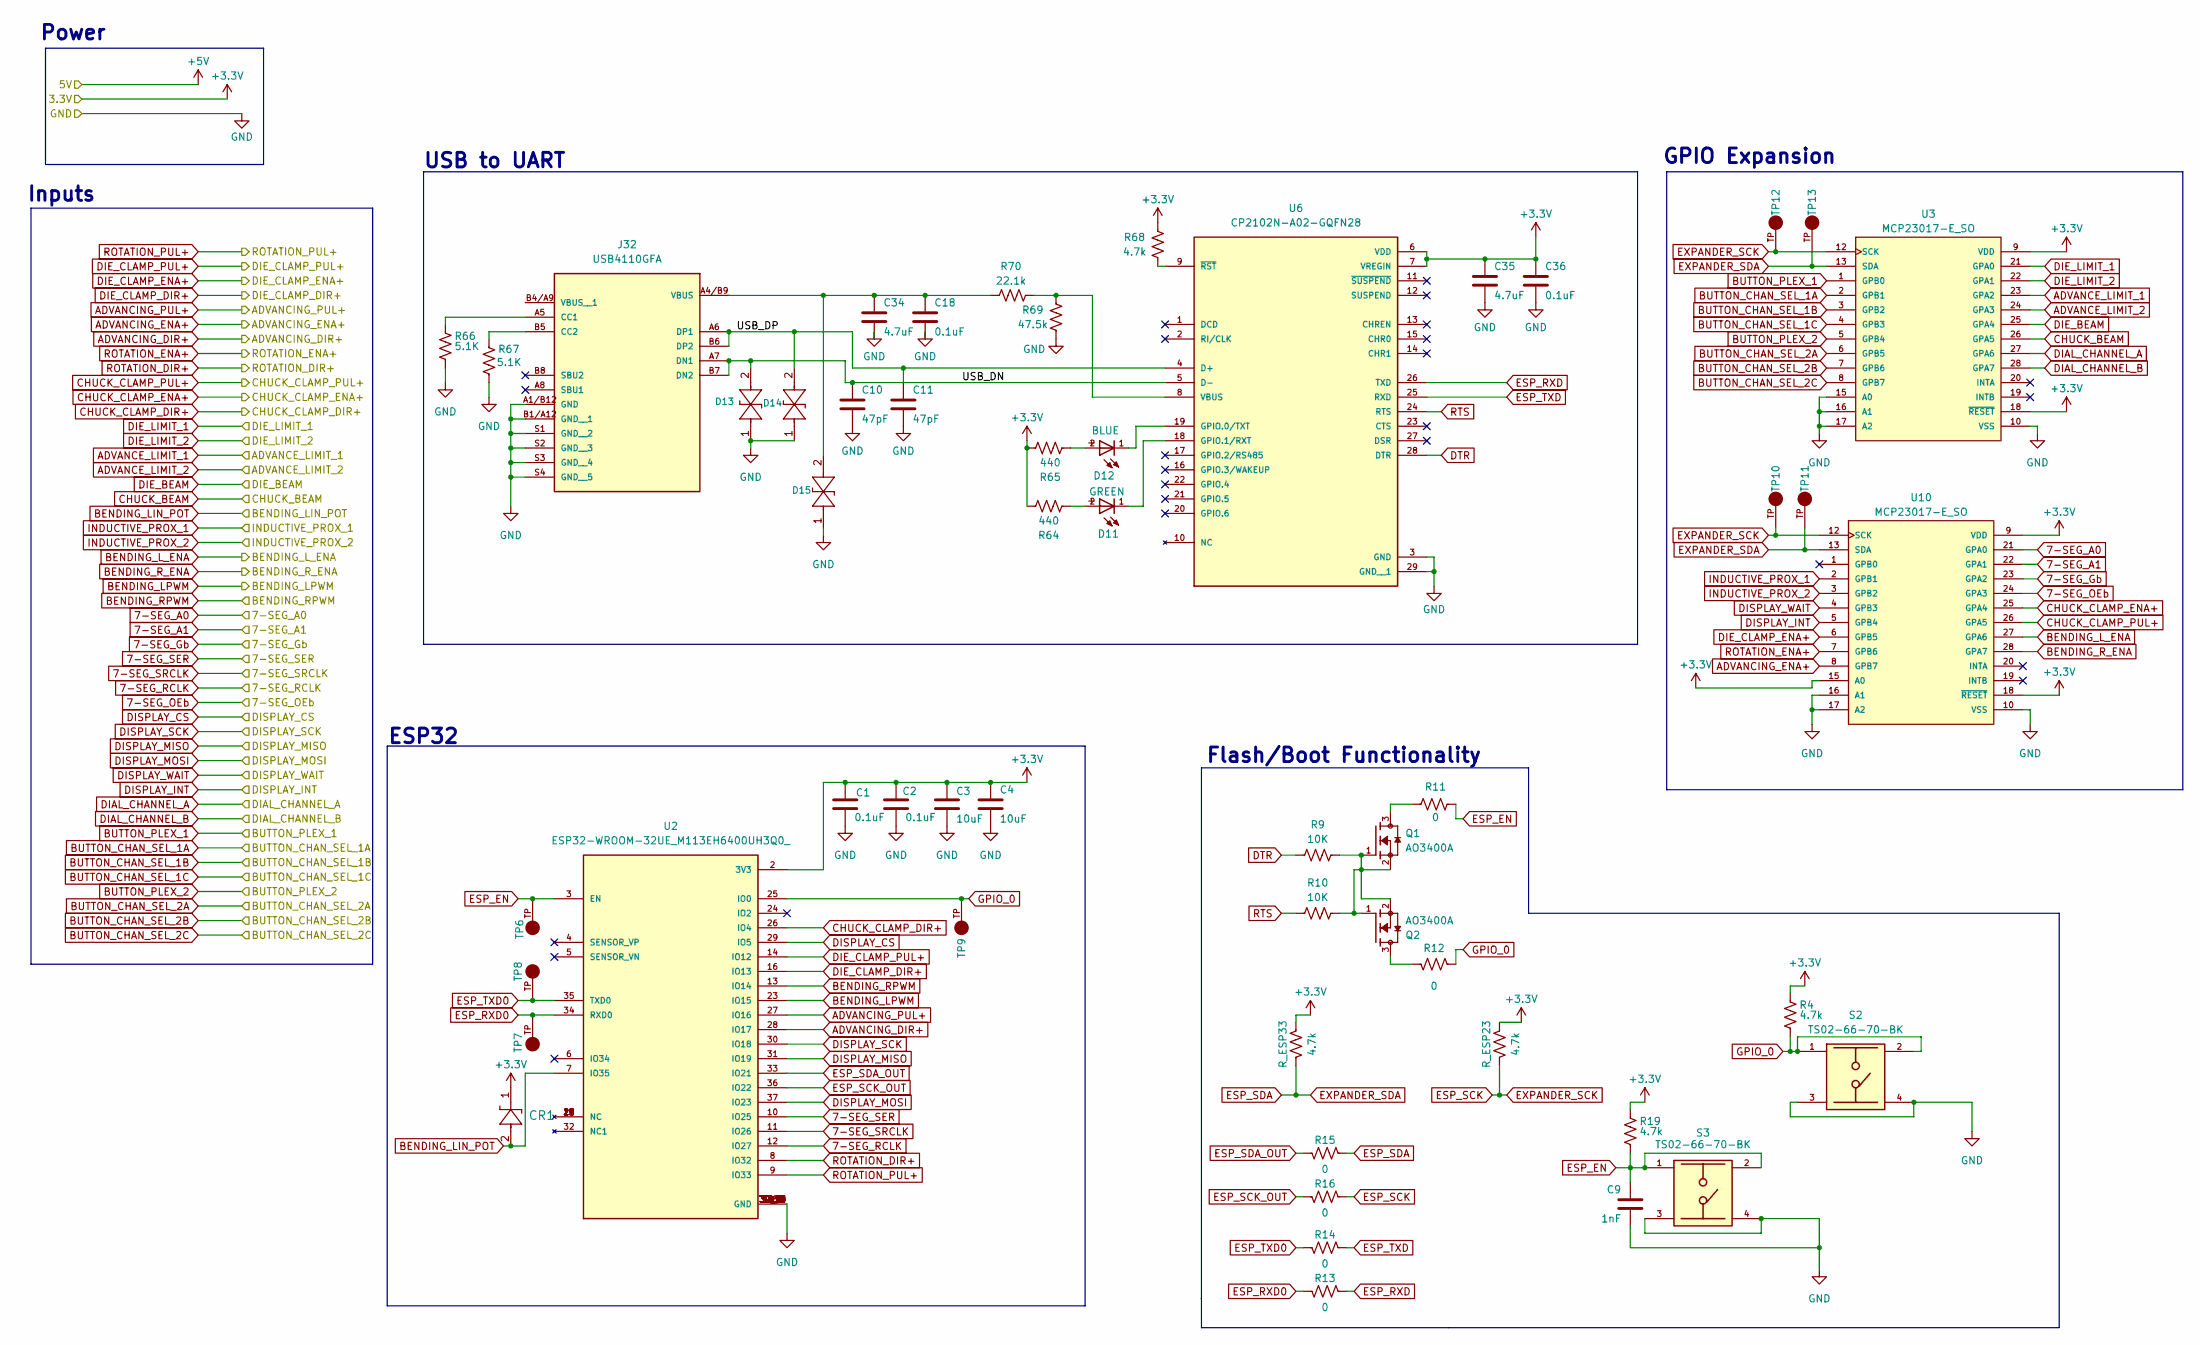
[picture p23: schematic control.kicad_sch]

Parts:
C1, C2, C18, C36: 0.1uF; C_0805_2012Metric
C3, C4: 10uF; C_0805_2012Metric
C9: 1nF; C_0805_2012Metric
C10, C11: 47pF; C_0805_2012Metric
C34, C35: 4.7uF; C_0805_2012Metric
CR1: PMEG4010CEH; SOD123F_NXP
D11: GREEN; WL-SMCW_0603
D12: BLUE; WL-SMCW_0603
D13, D14, D15: RCLAMP1521P.TCT; TVS_DFN2_SLP1006P2_SEM
J32: USB4110GFA; GCT_USB4110GFA
Q1, Q2: AO3400A; SOT95P280X125-3N; PARTREV L
R4, R19, R68: 4.7k; R_0805_2012Metric
R9, R10: 10K; R_0805_2012Metric
R11, R12, R13, R14, R15, R16: 0; R_0805_2012Metric
R64, R65: 440; R_0805_2012Metric
R66, R67: 5.1K; R_0805_2012Metric
R69: 47.5k; R_0805_2012Metric
R70: 22.1k; R_0805_2012Metric
R_ESP23, R_ESP33: 4.7k; R_0805_2012Metric
S2, S3: TS02-66-70-BK; SW_TS02-66-70-BK-260-LCR-D; PARTREV 1.0
TP6, TP7, TP8, TP9, TP10, TP11, TP12, TP13: 5006; KEYSTONE_5006; PARTREV F
U2: ESP32-WROOM-32UE_M113EH6400UH3Q0_; MODULE_ESP32-WROOM-32UE_M113EH6400UH3Q0_; PARTREV 1.2
U3, U10: MCP23017-E_SO; SOIC127P1030X265-28N; PARTREV C
U6: CP2102N-A02-GQFN28; QFN50P500X500X80-29N; PARTREV 1.5

Connections:
3.3V: C1.1, C2.1, C3.1, C4.1, C35.1, C36.1, CR1.1, R4.2, R19.2, R64.2, R65.2, R68.2, R_ESP23.2, R_ESP33.2, U2.2 (3V3), U3.9 (VDD), U3.18 (~RESET), U6.6 (VDD), U6.7 (VREGIN), U10.9 (VDD), U10.15 (A0), U10.18 (~RESET); also elsewhere on the board
7-SEG_A0: U10.21 (GPA0); also elsewhere on the board
7-SEG_A1: U10.22 (GPA1); also elsewhere on the board
7-SEG_Gb: U10.23 (GPA2); also elsewhere on the board
7-SEG_OEb: U10.24 (GPA3); also elsewhere on the board
7-SEG_RCLK: U2.12 (IO27); also elsewhere on the board
7-SEG_SER: U2.10 (IO25); also elsewhere on the board
7-SEG_SRCLK: U2.11 (IO26); also elsewhere on the board
/CONTROL/USB_DN: C10.1, D13.2, J32.A7 (DN1), J32.B7 (DN2), U6.5 (D-)
/CONTROL/USB_DP: C11.1, D14.2, J32.A6 (DP1), J32.B6 (DP2), U6.4 (D+)
ADVANCE_LIMIT_1: U3.23 (GPA2); also elsewhere on the board
ADVANCE_LIMIT_2: U3.24 (GPA3); also elsewhere on the board
ADVANCING_DIR+: U2.28 (IO17); also elsewhere on the board
ADVANCING_ENA+: U10.8 (GPB7); also elsewhere on the board
ADVANCING_PUL+: U2.27 (IO16); also elsewhere on the board
BENDING_LIN_POT: CR1.2, U2.7 (IO35); also elsewhere on the board
BENDING_LPWM: U2.23 (IO15); also elsewhere on the board
BENDING_L_ENA: U10.27 (GPA6); also elsewhere on the board
BENDING_RPWM: U2.13 (IO14); also elsewhere on the board
BENDING_R_ENA: U10.28 (GPA7); also elsewhere on the board
BUTTON_CHAN_SEL_1A: U3.2 (GPB1); also elsewhere on the board
BUTTON_CHAN_SEL_1B: U3.3 (GPB2); also elsewhere on the board
BUTTON_CHAN_SEL_1C: U3.4 (GPB3); also elsewhere on the board
BUTTON_CHAN_SEL_2A: U3.6 (GPB5); also elsewhere on the board
BUTTON_CHAN_SEL_2B: U3.7 (GPB6); also elsewhere on the board
BUTTON_CHAN_SEL_2C: U3.8 (GPB7); also elsewhere on the board
BUTTON_PLEX_1: U3.1 (GPB0); also elsewhere on the board
BUTTON_PLEX_2: U3.5 (GPB4); also elsewhere on the board
CHUCK_BEAM: U3.26 (GPA5); also elsewhere on the board
CHUCK_CLAMP_DIR+: U2.26 (IO4); also elsewhere on the board
CHUCK_CLAMP_ENA+: U10.25 (GPA4); also elsewhere on the board
CHUCK_CLAMP_PUL+: U10.26 (GPA5); also elsewhere on the board
DIAL_CHANNEL_A: U3.27 (GPA6); also elsewhere on the board
DIAL_CHANNEL_B: U3.28 (GPA7); also elsewhere on the board
DIE_CLAMP_DIR+: U2.16 (IO13); also elsewhere on the board
DIE_CLAMP_ENA+: U10.6 (GPB5); also elsewhere on the board
DIE_CLAMP_PUL+: U2.14 (IO12); also elsewhere on the board
DIE_LIMIT_1: U3.21 (GPA0); also elsewhere on the board
DIE_LIMIT_2: U3.22 (GPA1); also elsewhere on the board
DISPLAY_CS: U2.29 (IO5); also elsewhere on the board
DISPLAY_INT: U10.5 (GPB4); also elsewhere on the board
DISPLAY_MISO: U2.31 (IO19); also elsewhere on the board
DISPLAY_MOSI: U2.37 (IO23); also elsewhere on the board
DISPLAY_SCK: U2.30 (IO18); also elsewhere on the board
DISPLAY_WAIT: U10.4 (GPB3); also elsewhere on the board
DTR: R9.1, U6.28 (DTR)
ESP_EN: C9.1, R11.2, R19.1, S3.1, S3.2, TP6.TP, U2.3 (EN)
ESP_RXD: R13.2, U6.26 (TXD)
ESP_RXD0: R13.1, TP7.TP, U2.34 (RXD0)
ESP_SCK: R16.2, R_ESP23.1, TP10.TP, TP12.TP, U3.12 (SCK), U10.12 (SCK)
ESP_SCK_OUT: R16.1, U2.36 (IO22)
ESP_SDA: R15.2, R_ESP33.1, TP11.TP, TP13.TP, U3.13 (SDA), U10.13 (SDA)
ESP_SDA_OUT: R15.1, U2.33 (IO21)
ESP_TXD: R14.2, U6.25 (RXD)
ESP_TXD0: R14.1, TP8.TP, U2.35 (TXD0)
GPIO_0: R4.1, R12.2, S2.1, S2.2, TP9.TP, U2.25 (IO0)
INDUCTIVE_PROX_1: U10.2 (GPB1); also elsewhere on the board
INDUCTIVE_PROX_2: U10.3 (GPB2); also elsewhere on the board
unnamed: D11.2, R64.1
unnamed: D12.2, R65.1
unnamed: J32.A5 (CC1), R66.2
unnamed: J32.B5 (CC2), R67.2
unnamed: C18.1, C34.1, D15.2, J32.A4/B9 (VBUS), R70.1
unnamed: Q1.1, Q1.2, Q2.1, Q2.2, R9.2, R10.2
unnamed: Q1.3, R11.1
unnamed: Q2.3, R12.1
unnamed: D12.1, U6.19 (GPIO.0/TXT)
unnamed: D11.1, U6.18 (GPIO.1/RXT)
unnamed: R69.2, R70.2, U6.8 (VBUS)
unnamed: R68.1, U6.9 (~RST)
ROTATION_DIR+: U2.8 (IO32); also elsewhere on the board
ROTATION_ENA+: U10.7 (GPB6); also elsewhere on the board
ROTATION_PUL+: U2.9 (IO33); also elsewhere on the board
RTS: R10.1, U6.24 (RTS)

Notes on the sheet:
USB to UART
GPIO Expansion
Inputs
ESP32
Power
Flash/Boot Functionality
