smvumbaco/Tubender-FA24/production/ecad/Tubender PCB/Tubender PCB.kicad_pcb

## KiCad design production/ecad/Tubender PCB/Tubender PCB.kicad_pcb (continued)

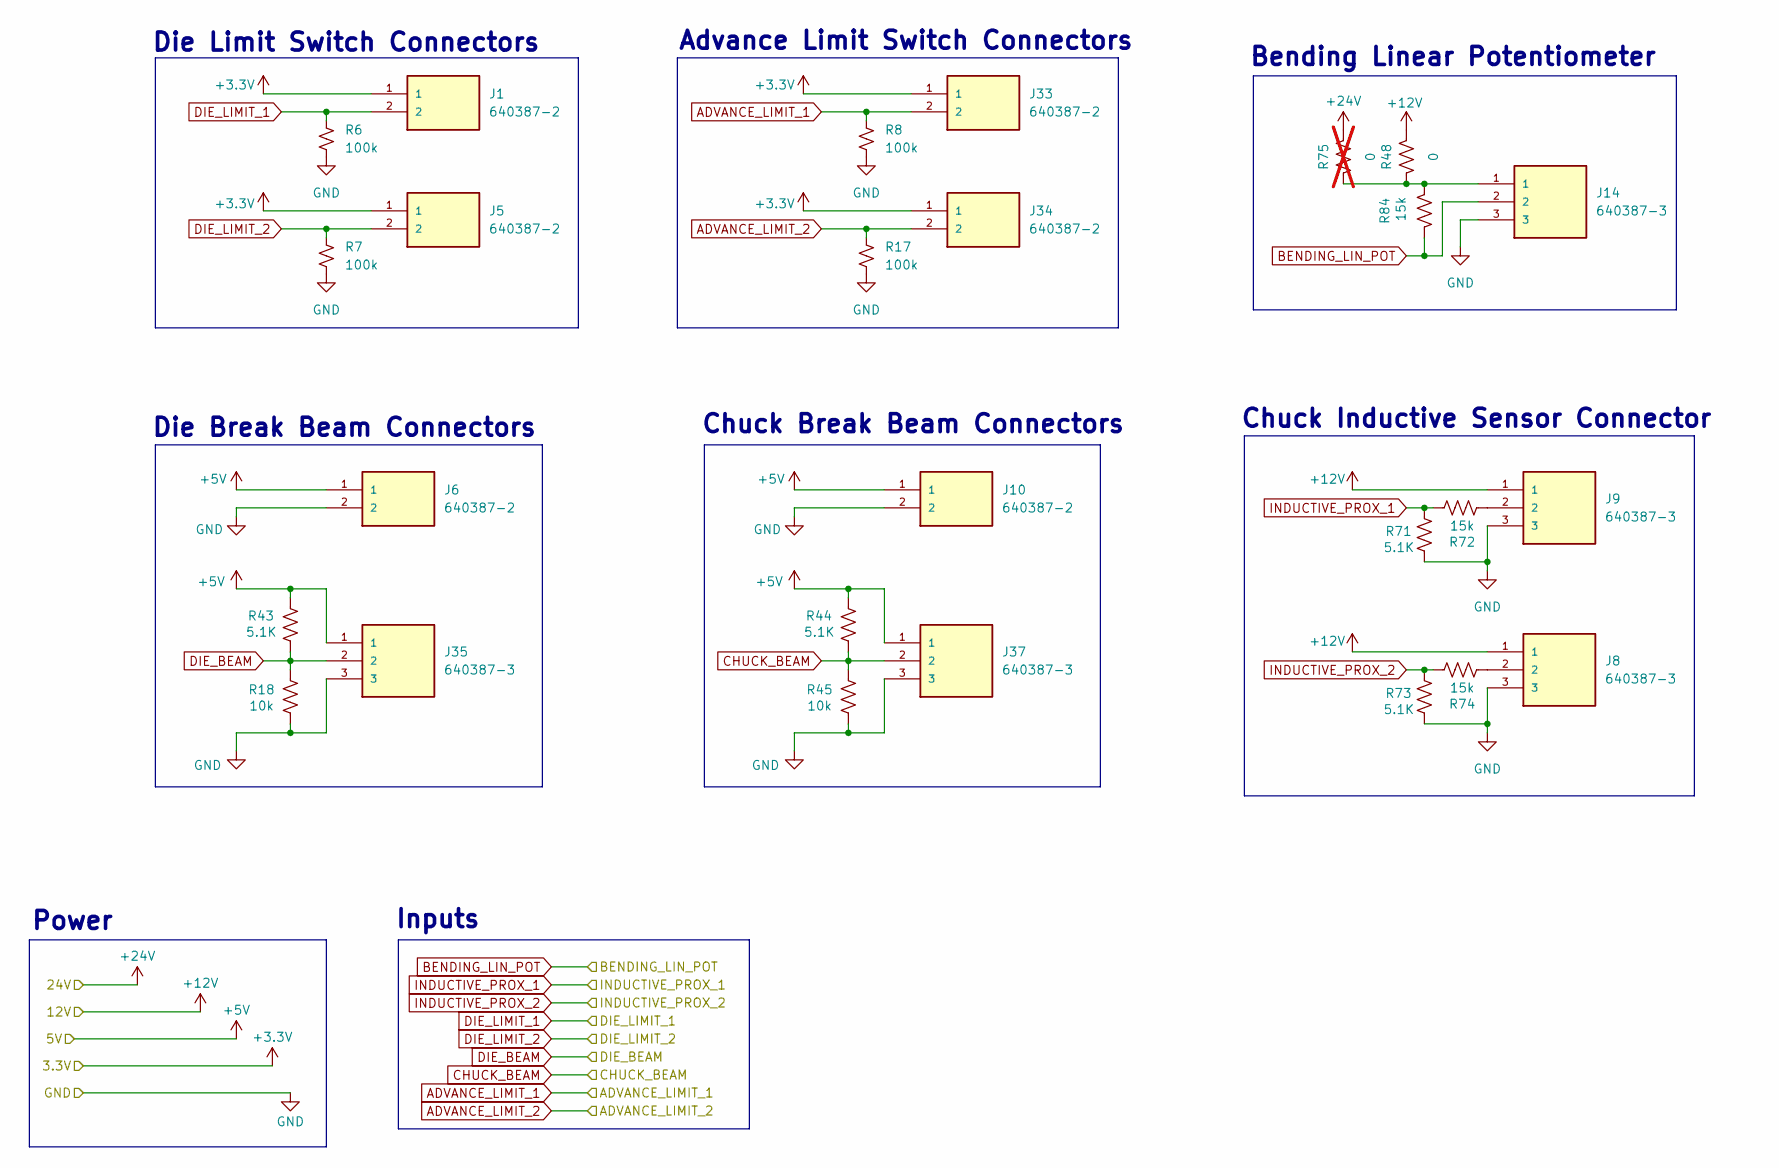
[picture p24: schematic sensors.kicad_sch]

Parts:
J1, J5, J6, J10, J33, J34: 640387-2; TE_640387-2; PARTREV R
J8, J9, J14, J35, J37: 640387-3; TE_640387-3; PARTREV R
R6, R7, R8, R17: 100k; R_0805_2012Metric
R18, R45: 10k; R_0805_2012Metric
R43, R44, R71, R73: 5.1K; R_0805_2012Metric
R48: 0; R_0805_2012Metric
R72, R74, R84: 15k; R_0805_2012Metric
R75: 0; R_0805_2012Metric; not fitted

Connections:
3.3V: J1.1, J5.1, J33.1, J34.1; also elsewhere on the board
24V: R75.2; also elsewhere on the board
ADVANCE_LIMIT_1: J33.2, R8.2; also elsewhere on the board
ADVANCE_LIMIT_2: J34.2, R17.2; also elsewhere on the board
BENDING_LIN_POT: J14.2, R84.1; also elsewhere on the board
CHUCK_BEAM: J37.2, R44.1, R45.2; also elsewhere on the board
DIE_LIMIT_1: J1.2, R6.2; also elsewhere on the board
DIE_LIMIT_2: J5.2, R7.2; also elsewhere on the board
INDUCTIVE_PROX_1: R71.2, R72.2; also elsewhere on the board
INDUCTIVE_PROX_2: R73.2, R74.2; also elsewhere on the board
unnamed: J8.2, R74.1
unnamed: J14.1, R48.1, R75.1, R84.2

Notes on the sheet:
Chuck Inductive Sensor Connector
Advance Limit Switch Connectors
Die Break Beam Connectors
Power
Inputs
Chuck Break Beam Connectors
Bending Linear Potentiometer
Die Limit Switch Connectors

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
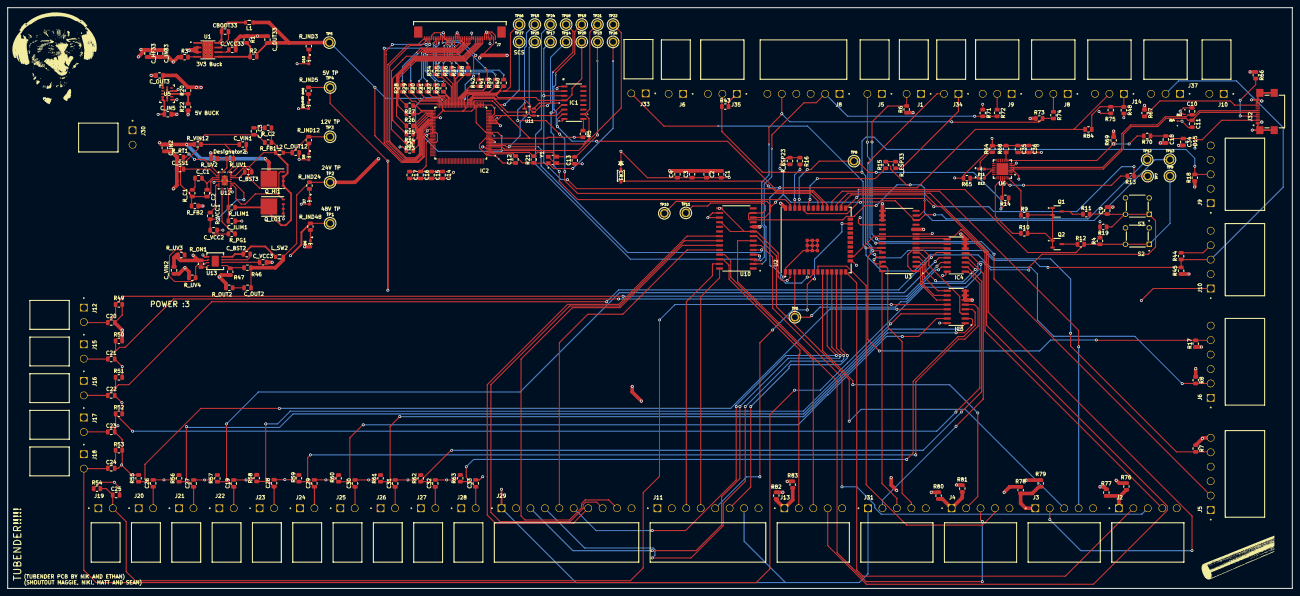
[picture p25: board Tubender PCB.kicad_pcb from above]

Board: 4 copper layers, 352.2 x 159.2 mm, 262 parts (0 on the bottom side), 192 nets.

Other parts of the board:
J5#2, J6#2, J8#2: 640387-6; TE_640387-6
J9#2: 640387-3; TE_640387-3
J10#2: 640387-5; TE_640387-5

Their connections:
ADVANCE_LIMIT_1: J6#2.2; also elsewhere on the board
ADVANCE_LIMIT_2: J6#2.5; also elsewhere on the board
CHUCK_BEAM: J10#2.3; also elsewhere on the board
DIE_LIMIT_1: J5#2.2; also elsewhere on the board
DIE_LIMIT_2: J5#2.5; also elsewhere on the board
INDUCTIVE_PROX_1: J8#2.2; also elsewhere on the board
INDUCTIVE_PROX_2: J8#2.5; also elsewhere on the board
