smvumbaco/Tubender-FA24/(commit log)

2024-09-12 Tubebender KiCAD File Upload
    Blank KiCAD with Hierarchical Pages Created
    [Tubender PCB.kicad_pcb, Tubender PCB.kicad_sch, untitled.kicad_sch]
2024-09-17 added name on power sheet
    [Tubender PCB.kicad_sch, untitled.kicad_sch]
2024-09-18 initial niki push
    [Tubender PCB.kicad_sch, untitled.kicad_sch]
2024-09-18 Added TItle
    [Tubender PCB.kicad_sch, untitled.kicad_sch]
2024-09-18 Matt Commit Message
    [Tubender PCB.kicad_sch]
2024-09-22 added 3.3V buck IC symbol and changed power sheet directory
    [Tubender PCB.kicad_sch, untitled.kicad_sch]
2024-09-22 sorry same commit but i forgot some stuff
    [LMR36520FADDAR.step, power.kicad_sch]
2024-09-26 just test push!
    [Tubender PCB.kicad_sch]
2024-09-29 Added 3V3 buck circuitry to main branch, added 3V3 label
    [Tubender PCB.kicad_sch, power.kicad_sch, untitled.kicad_sch]
2024-09-29 3V3 output cap value change based on phase margin
    [power.kicad_sch]
2024-10-02 First MCU Edit
    [untitled.kicad_sch]
2024-10-03 MCU and such
    [ESP32-WROOM-32UE_M113EH6400UH3Q0_.step, Tubender PCB.kicad_sch, control.kicad_sch, motors_actuators.kicad_sch, sensors.kicad_sch]
2024-10-03 More MCU Stuff
    [MCP2221A-I_SL.step, USB4110GFA.step, control.kicad_sch]
2024-10-03 MCU Rev1 Complete
    [1N5819HW-7-F.step, AO3400A.step, FT232RL-REEL.step, JS202011JCQN.step, MCP2221A-I_SL.step, MCP23017-E_SO.step, TS02-66-70-BK-260-LCR-D.step, WL-SMCW_0603.step]
2024-10-03 Added Motor Connectors
    [1729157.step, motors_actuators.kicad_sch]
2024-10-03 Fixed a Switch or 2
    [control.kicad_sch]
2024-10-06 Add UI sheet
    [Tubender PCB.kicad_sch, user_interface.kicad_sch]
2024-10-06 Add UI sheet sections
    [user_interface.kicad_sch]
2024-10-07 Added IC and some connections for 12V buck. Added 12V output connection
    [power.kicad_sch]
2024-10-07 Added Prox Sensor Nets
    [sensors.kicad_sch]
2024-10-08 All passives valued for 12V buck
    [power.kicad_sch]
2024-10-08 Add buck converter datasheets
2024-10-08 Add 5V 20mA buck, symbol, footprint, and datasheet
    [power.kicad_sch]
2024-10-09 Motor Page
    [motors_actuators.kicad_sch]
2024-10-09 add box to identify 12V and 5V buck
    [power.kicad_sch]
2024-10-09 8 connector
    [motors_actuators.kicad_sch]
2024-10-09 names and stuff
    [TPSM265R1V5SILR.step, power.kicad_sch]
2024-10-09 GRRR deleted old files
    [power.kicad_sch]
2024-10-09 sensor connectors - niki
    [sensors.kicad_sch]
2024-10-09 STATUS LEDS!!!
    [power.kicad_sch]
2024-10-10 adding 3pin connector
    [sensors.kicad_sch]
2024-10-10 Added UI components, shift registers, and mux
    [user_interface.kicad_sch]
2024-10-10 add UI components
    [user_interface.kicad_sch]
2024-10-10 Temp page added
    [Tubender PCB.kicad_sch, temp.kicad_sch, user_interface.kicad_sch]
2024-10-11 7 Segment, Buttons, Plexers Oh MY!
    [CD4051BE.step, control.kicad_sch, power.kicad_sch, temp.kicad_sch]
2024-10-11 Driver pin out
    [temp.kicad_sch, user_interface.kicad_sch]
2024-10-11 Yay, more components!
    Buffer and Crystal
    [ABM8-20.000MHz-10-B1U-T.step, SN74AHC1G125DBVR.step]
2024-10-11 More driver pins yay
    [user_interface.kicad_sch]
2024-10-11 Formatting
    Boom
    [motors_actuators.kicad_sch, power.kicad_sch, sensors.kicad_sch]
2024-10-11 24V Buck Said WHOOO?!
    [power.kicad_sch]
2024-10-11 Completed RA8875 Driver
    [user_interface.kicad_sch]
2024-10-11 final for rev 1
    [Tubender PCB.kicad_sch, motors_actuators.kicad_sch, sensors.kicad_sch, temp.kicad_sch, user_interface.kicad_sch]
2024-10-11 Display to MCU
    Forgot to add global nets for display to the control page, my b
    [control.kicad_sch, user_interface.kicad_sch]
2024-10-11 Fixed Button Connectors
    All done! Enjoy :)
    [640387-3.step, 640387-6.step, 640387-8.step, Tubender PCB.kicad_sch, motors_actuators.kicad_sch, power.kicad_sch, sensors.kicad_sch, user_interface.kicad_sch]
2024-10-12 Fixed 12V buck and power LEDs
    [power.kicad_sch]
2024-10-14 Moved Display SPI to MCU VSPI and Organized UI Sheet
    [control.kicad_sch, user_interface.kicad_sch]
2024-10-15 Separated into Two PCBS
    UI and Main now seperated
    [Tubender Main_PCB.kicad_pcb, Tubender Main_PCB.kicad_sch, Tubender UI_PCB.kicad_pcb, Tubender UI_PCB.kicad_sch, control.kicad_sch, motors_actuators.kicad_sch, power.kicad_sch, sensors.kicad_sch]
2024-10-15 Fixed the Nets
    [Tubender Main_PCB.kicad_sch, control.kicad_sch, motors_actuators.kicad_sch, power.kicad_sch, sensors.kicad_sch]
2024-10-16 Fixing Sheets, 1 Board Again
    [Tubender Main_PCB.kicad_sch, Tubender PCB.kicad_pcb, Tubender PCB.kicad_sch, Tubender UI_PCB.kicad_pcb, Tubender UI_PCB.kicad_sch, control.kicad_sch, motors_actuators.kicad_sch, power.kicad_sch]
2024-10-16 Adding Test Points
    [5006.step, control.kicad_sch, power.kicad_sch]
2024-10-16 Change input labels to outputs
    [user_interface.kicad_sch]
2024-10-16 Make 2nd Board
    [1-640387-0.step, Tubender UI_PCB.kicad_pcb, Tubender UI_PCB.kicad_sch, control.kicad_sch, motors_actuators.kicad_sch, power.kicad_sch, sensors.kicad_sch, temp.kicad_sch]
2024-10-16 Reorganized UI
    [user_interface.kicad_sch]
2024-10-16 errrmskt, what the sigma?
    [1050170001.stp, 150080GS75000.step, 5033950410.stp, 691137710002.stp, 691137710004--3DModel-STEP-56544.STEP, ABLS-12.000MHZ-20-B4Y-T.step, CDRH127_LDNP-330MC.stp, CUI_DEVICES_TS04-66-55-BK-160-SMT.step]
2024-10-16 Fix it?
    [1-640387-0.step, 1050170001.stp, 150080GS75000.step, 1729157.step, 1N5819HW-7-F.step, 5006.step, 5033950410.stp, 640387-3.step]
2024-10-16 Replace outdated shift register
    [user_interface.kicad_sch]
2024-10-16 Fixing output/input markers
    [control.kicad_sch]
2024-10-16 Layout File Made
    [Tubender PCB.kicad_pcb]
2024-10-16 UI Board Fully Separated Now
    [Tubender UI_PCB.kicad_sch, user_interface.kicad_sch]
2024-10-16 Flashing and Buttons
    Moved to a more proven way to flash ESP's and also made all the buttons pull ups instead of pull downs.
    [CP2102N-A02-GQFN28.step, control.kicad_sch]
2024-10-17 Just tinkering with Nets
    [Tubender PCB.kicad_sch]
2024-10-17 annotate schematic
    [control.kicad_sch, power.kicad_sch, sensors.kicad_sch, user_interface.kicad_sch]
2024-10-17 start power layout
    [Tubender PCB.kicad_pcb, control.kicad_sch, motors_actuators.kicad_sch, power.kicad_sch, sensors.kicad_sch, user_interface.kicad_sch]
2024-10-17 Replaced MUX IC and connected touch functionality pins
    [user_interface.kicad_sch]
2024-10-18 layed out most buck architectures, one status led
    [Tubender PCB.kicad_pcb, power.kicad_sch]
2024-10-20 unsure update
    [Tubender PCB.kicad_pcb]
2024-10-20 Added Testpoints to UI sheet
    [power.kicad_sch, user_interface.kicad_sch]
2024-10-20 pcb changes
2024-10-20 GITHUB IS NOT MY FRIEND
    [Tubender PCB.kicad_pcb]
2024-10-21 Power mostly complete
    [Tubender PCB.kicad_pcb]
2024-10-21 quick pcb edit
    [Tubender PCB.kicad_pcb]
2024-10-22 sensor updates!
    [Tubender PCB.kicad_sch, sensors.kicad_sch]
2024-10-22 connected one line on 5V Buck
    [Tubender PCB.kicad_pcb]
2024-10-23 trying to fix trace issue
2024-10-23 starting to layout non-power stuff
    [Tubender PCB.kicad_pcb]
2024-10-23 Added Footprints
    [user_interface.kicad_sch]
2024-10-23 more changes
    [Tubender PCB.kicad_pcb]
2024-10-23 working on mcu layout
    [Tubender PCB.kicad_pcb, sensors.kicad_sch, user_interface.kicad_sch]
2024-10-23 More FootyPrints
    [Tubender UI_PCB.kicad_pcb, user_interface.kicad_sch]
2024-10-23 a few lines here and there
    [Tubender PCB.kicad_pcb]
2024-10-24 added some traces
    [Tubender PCB.kicad_pcb]
2024-10-25 small change, removed one trace
    [Tubender PCB.kicad_pcb]
2024-10-25 Added SD card reader
    [user_interface.kicad_sch]
2024-10-26 Some intial work for rotary encoder on PCB
    [Tubender UI_PCB.kicad_pcb, user_interface.kicad_sch]
2024-10-27 more traces
    [Tubender PCB.kicad_pcb]
2024-10-28 lots of traces complete, USB-UART pretty much complete and flash/boot functionality pretty much complete
    [Tubender PCB.kicad_pcb]
2024-10-29 Added UI footprints and first draft of layout
    [Tubender UI_PCB.kicad_pcb]
2024-10-29 Added SD Connector to UI PCB
    [user_interface.kicad_sch]
2024-10-30 ADDED POWER AND GROUND PLANE AND DID MORE TRACES
    [Tubender PCB.kicad_pcb]
2024-10-30 almost done
    [Tubender PCB.kicad_pcb]
2024-10-31 minor changes and vias
    [Tubender PCB.kicad_pcb, control.kicad_sch]
2024-10-31 0 Ohm Resistors
    Added DNP 0 Ohm's connected to the 24V rail to the motor connectors power out pin. This is in case we have issues with the drivers taking 48 volts and to just have flexbility
    [Tubender PCB.kicad_sch, motors_actuators.kicad_sch]
2024-10-31 Layout for 0 Ohm Resistors
    [Tubender PCB.kicad_pcb]
2024-10-31 Fixed MCU Pinout Schematic
    [control.kicad_sch]
2024-10-31 More MCU Updates
    [control.kicad_sch]
2024-10-31 Updated Layout for new MCU Connections
    [Tubender PCB.kicad_pcb, control.kicad_sch]
2024-10-31 Added Display Daughter Board PCB and start UI layout
    [Tubender Display_PCB.kicad_pcb, Tubender Display_PCB.kicad_sch, Tubender UI_PCB.kicad_pcb, expander.kicad_sch, user_interface.kicad_sch]
2024-10-31 Differential Pairs
    [Tubender PCB.kicad_pcb, control.kicad_sch]
2024-10-31 small changes and reducing errors
    [Tubender PCB.kicad_pcb, user_interface.kicad_sch]
2024-10-31 Finished First Draft Layout of UI PCB
    [Tubender UI_PCB.kicad_pcb, user_interface.kicad_sch]
2024-11-01 Potentiometer Update
    [control.kicad_sch, sensors.kicad_sch]
2024-11-02 got rid of all drc issues
    [Tubender PCB.kicad_pcb, power.kicad_sch]
2024-11-03 quick push with diode
    [Tubender PCB.kicad_pcb, control.kicad_sch]
2024-11-03 final connectors!
    [Tubender PCB.kicad_pcb]
2024-11-04 Fixed RC Cap Value
    [user_interface.kicad_sch]
2024-11-04 Duplicate Connectors on Main PCB
    [Tubender PCB.kicad_pcb]
2024-11-04 Resolved DRC Erros on connector board
    [Tubender Display_PCB.kicad_pcb]
2024-11-04 quick changes
    [Tubender PCB.kicad_pcb]
2024-11-04 sorry ignore me
    [Tubender PCB.kicad_pcb]
2024-11-04 Revert "sorry ignore me"
    This reverts commit 73c02b3aeddfc779c4a0e0557f647e9a66e19b2e.
    [Tubender PCB.kicad_pcb]
2024-11-04 Revert "okay"
    This reverts commit a5d04aacf17b2a0e1fddfefa2daa114170fce467, reversing
    changes made to 85b8c41c143529192f5821f916a37eef7153b122.
    [Tubender Display_PCB.kicad_pcb, Tubender PCB.kicad_pcb]
2024-11-04 Revert "quick changes"
    This reverts commit 85b8c41c143529192f5821f916a37eef7153b122.
    [Tubender PCB.kicad_pcb]
2024-11-04 Fixed DRC issues with UI board and added mounting holes
    [640387-5.stp, Tubender UI_PCB.kicad_pcb, user_interface.kicad_sch]
2024-11-05 Fixed daughter board DRC issues
    [Tubender Display_PCB.kicad_pcb]
2024-11-20 Added STEP files for UI board
    [104031-0811.stp, BX56.IGS, D0016A.stp, PEC11R-4215K-S0024.stp, SN74LVC1G29DCTR.stp, Tubender UI_PCB.kicad_pcb]
